IowaScaledEngineering/mss-cascade/doc/cascade-bag-top-landscape.odt

Iowa Scaled Engineering, LLC

http://iascaled.com/

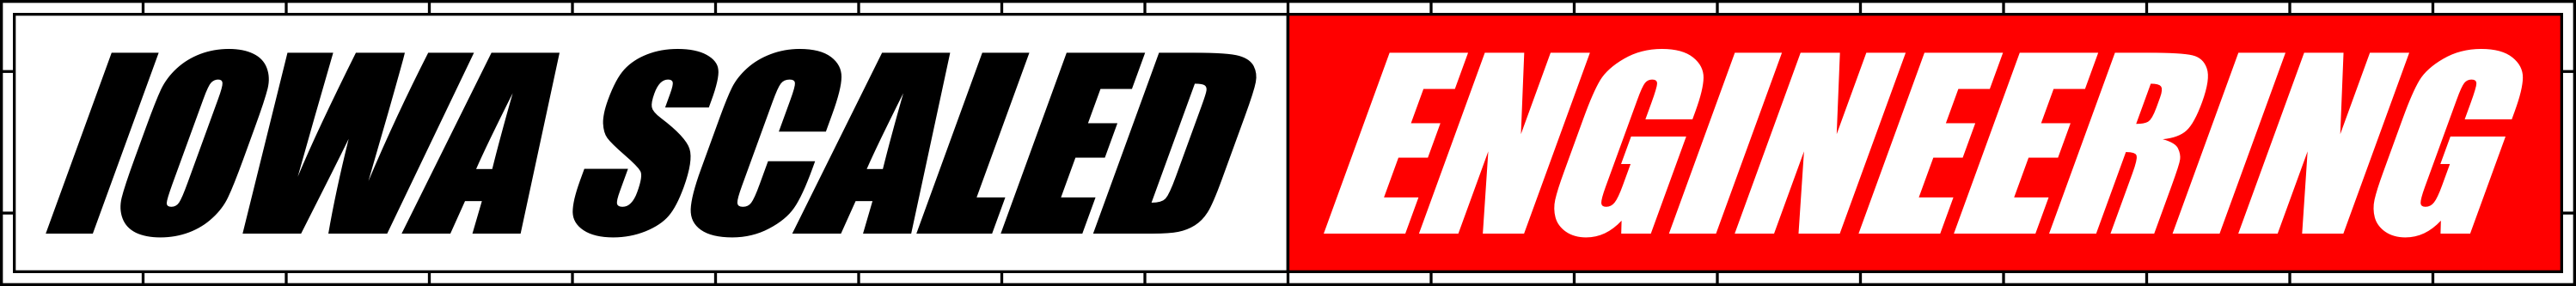
[picture p1: figure]

Modular Signaling System
Cascade Module

The MSS-CASCADE is a fully integrated module implementing the Module Signaling System (MSS) cascade function, providing simple ABS signal functionality at a block boundary. It contains the block detection circuitry, optical detector, MSS bus logic, and LED signal drivers.

MSS-CASCADE
