IowaScaledEngineering/mss-cascade/pg/mss-cascade-adv-v1.0-99f0320/mss-cascade-adv.pdf

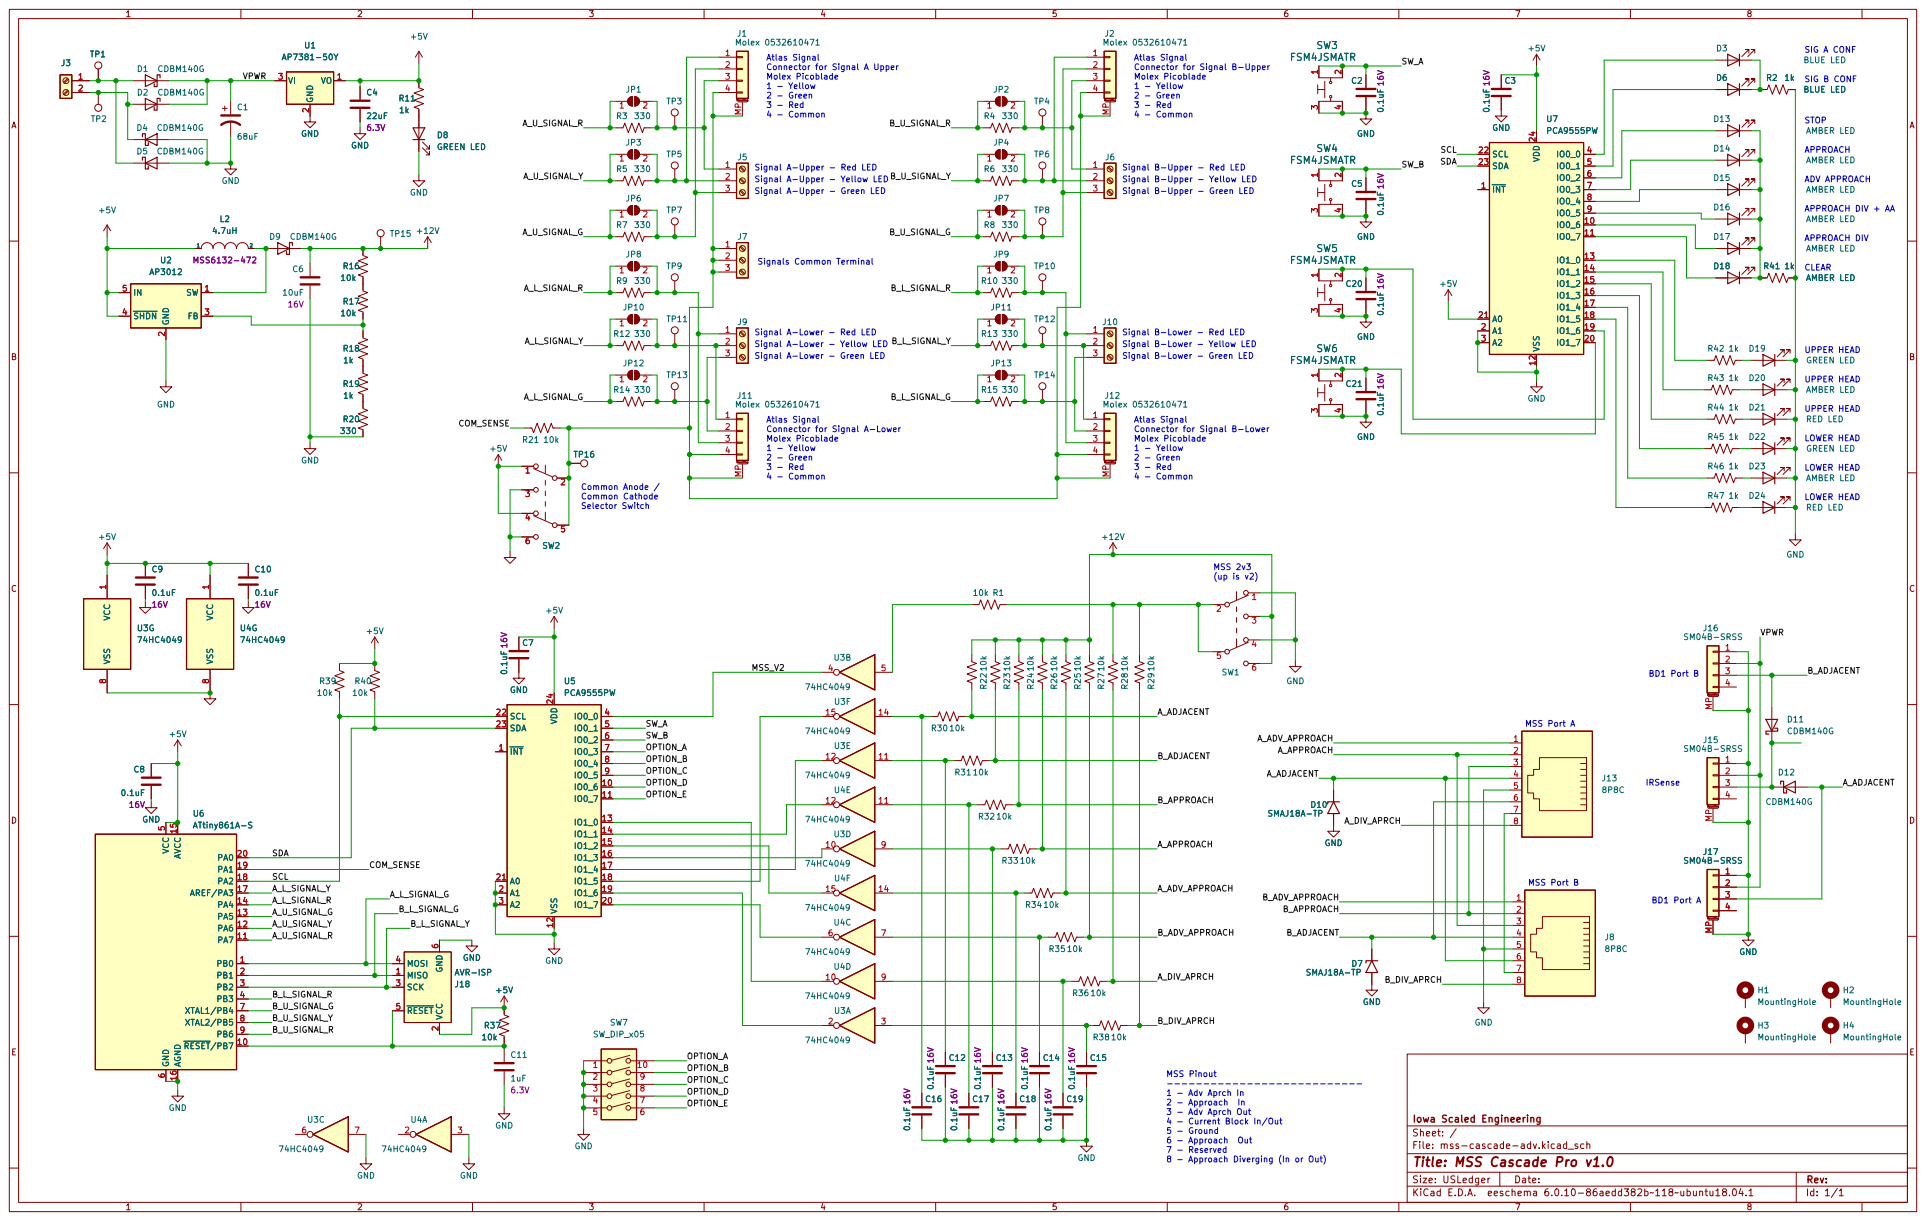
[picture p8: page 1]

Atlas Signal
Connector for Signal A Upper Molex Picoblade

Connector for Signal B-Upper Molex Picoblade

Signal B-Lower - Red LED
Signal B-Lower - Yellow LED
4 - Common Signal B-Lower - Green LED

Connector for Signal A-Lower Molex Picoblade

Connector for Signal B-Lower Molex Picoblade

2 SCK 3 MOSI 4 ~{RESET} 5 GND

MSS Pinout --------------------------- 1 - Adv Aprch In

2 - Approach In
3 - Adv Aprch Out 4 - Current Block In/Out 5 - Ground

Iowa Scaled Engineering
File: mss-cascade-adv.kicad_sch Sheet: /
Id: 1/1 Title: MSS Cascade Pro v1.0

8 - Approach Diverging (In or Out)
