IowaScaledEngineering/mss-cascade/pg/mss-cascade-basic-v1.1-02db50d/mss-cascade-basic.pdf

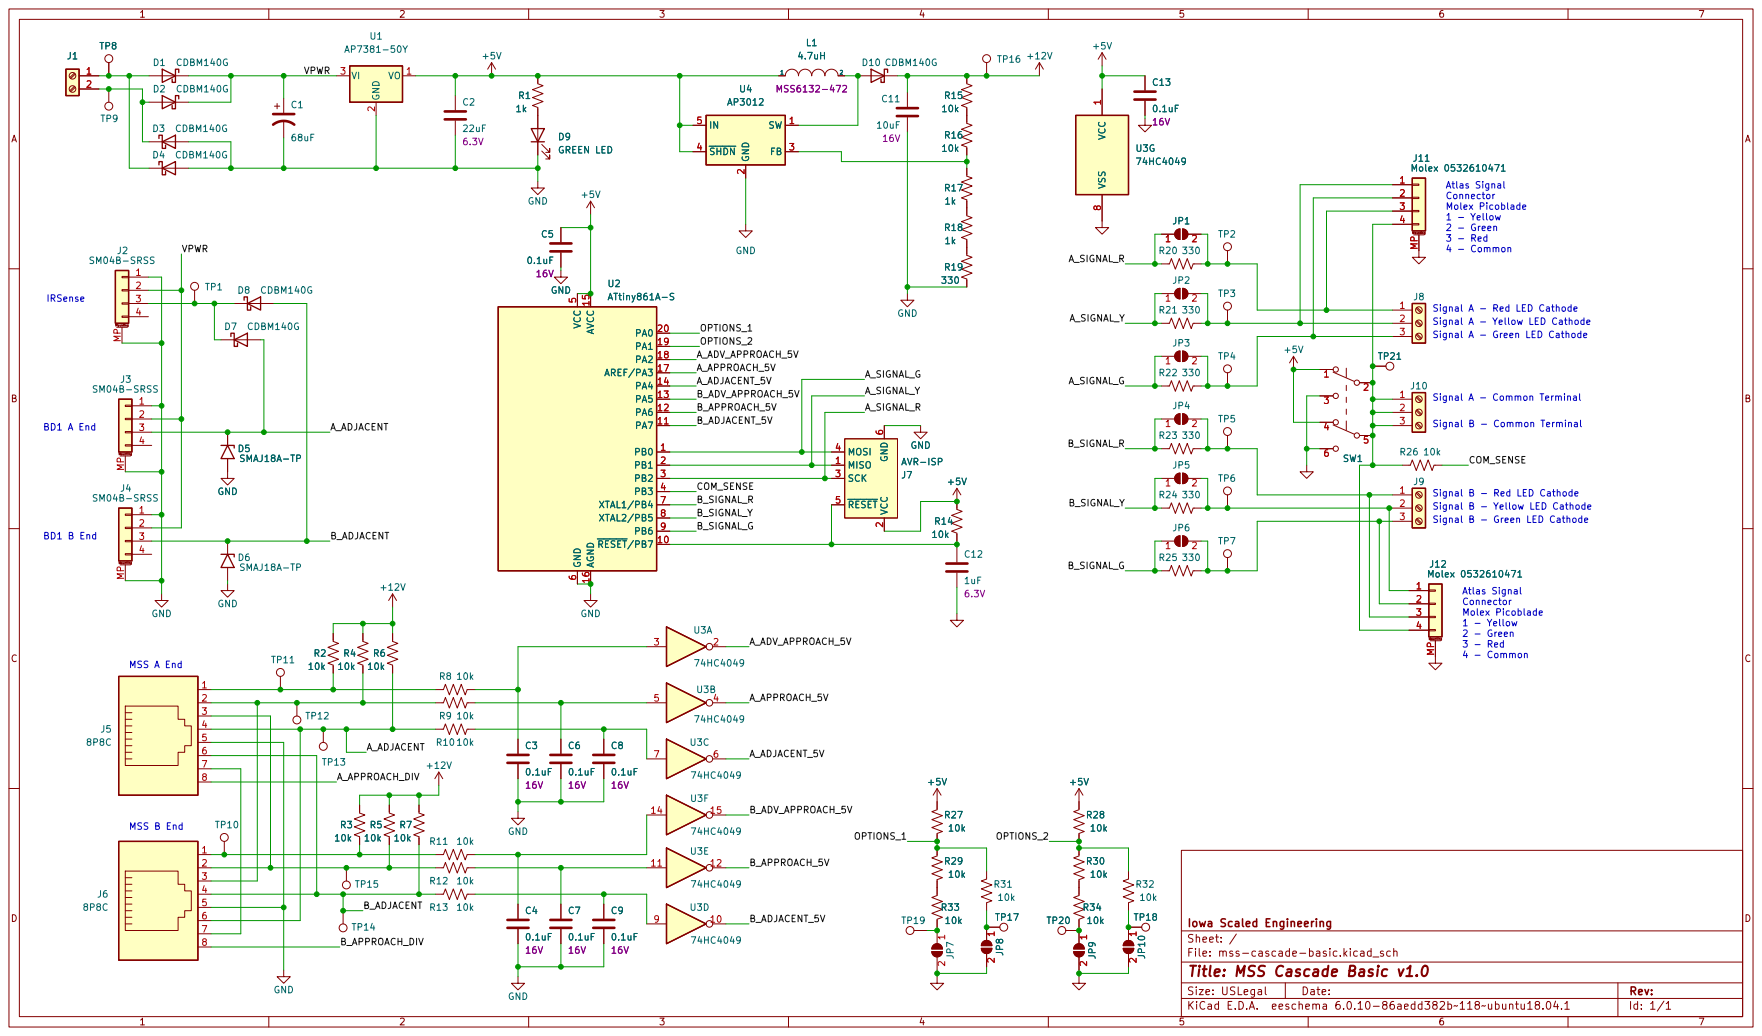
[picture p9: page 1]

Atlas Signal Connector Molex Picoblade

2 SCK 3 MOSI 4 ~{RESET} 5 GND

Signal B - Red LED Cathode

Signal B - Green LED Cathode

Iowa Scaled Engineering
File: mss-cascade-basic.kicad_sch Sheet: /
Id: 1/1 Title: MSS Cascade Basic v1.0
