IowaScaledEngineering/mss-cascade/pg/mss-cascade-v1.1-7f48456/mss-cascade.pdf

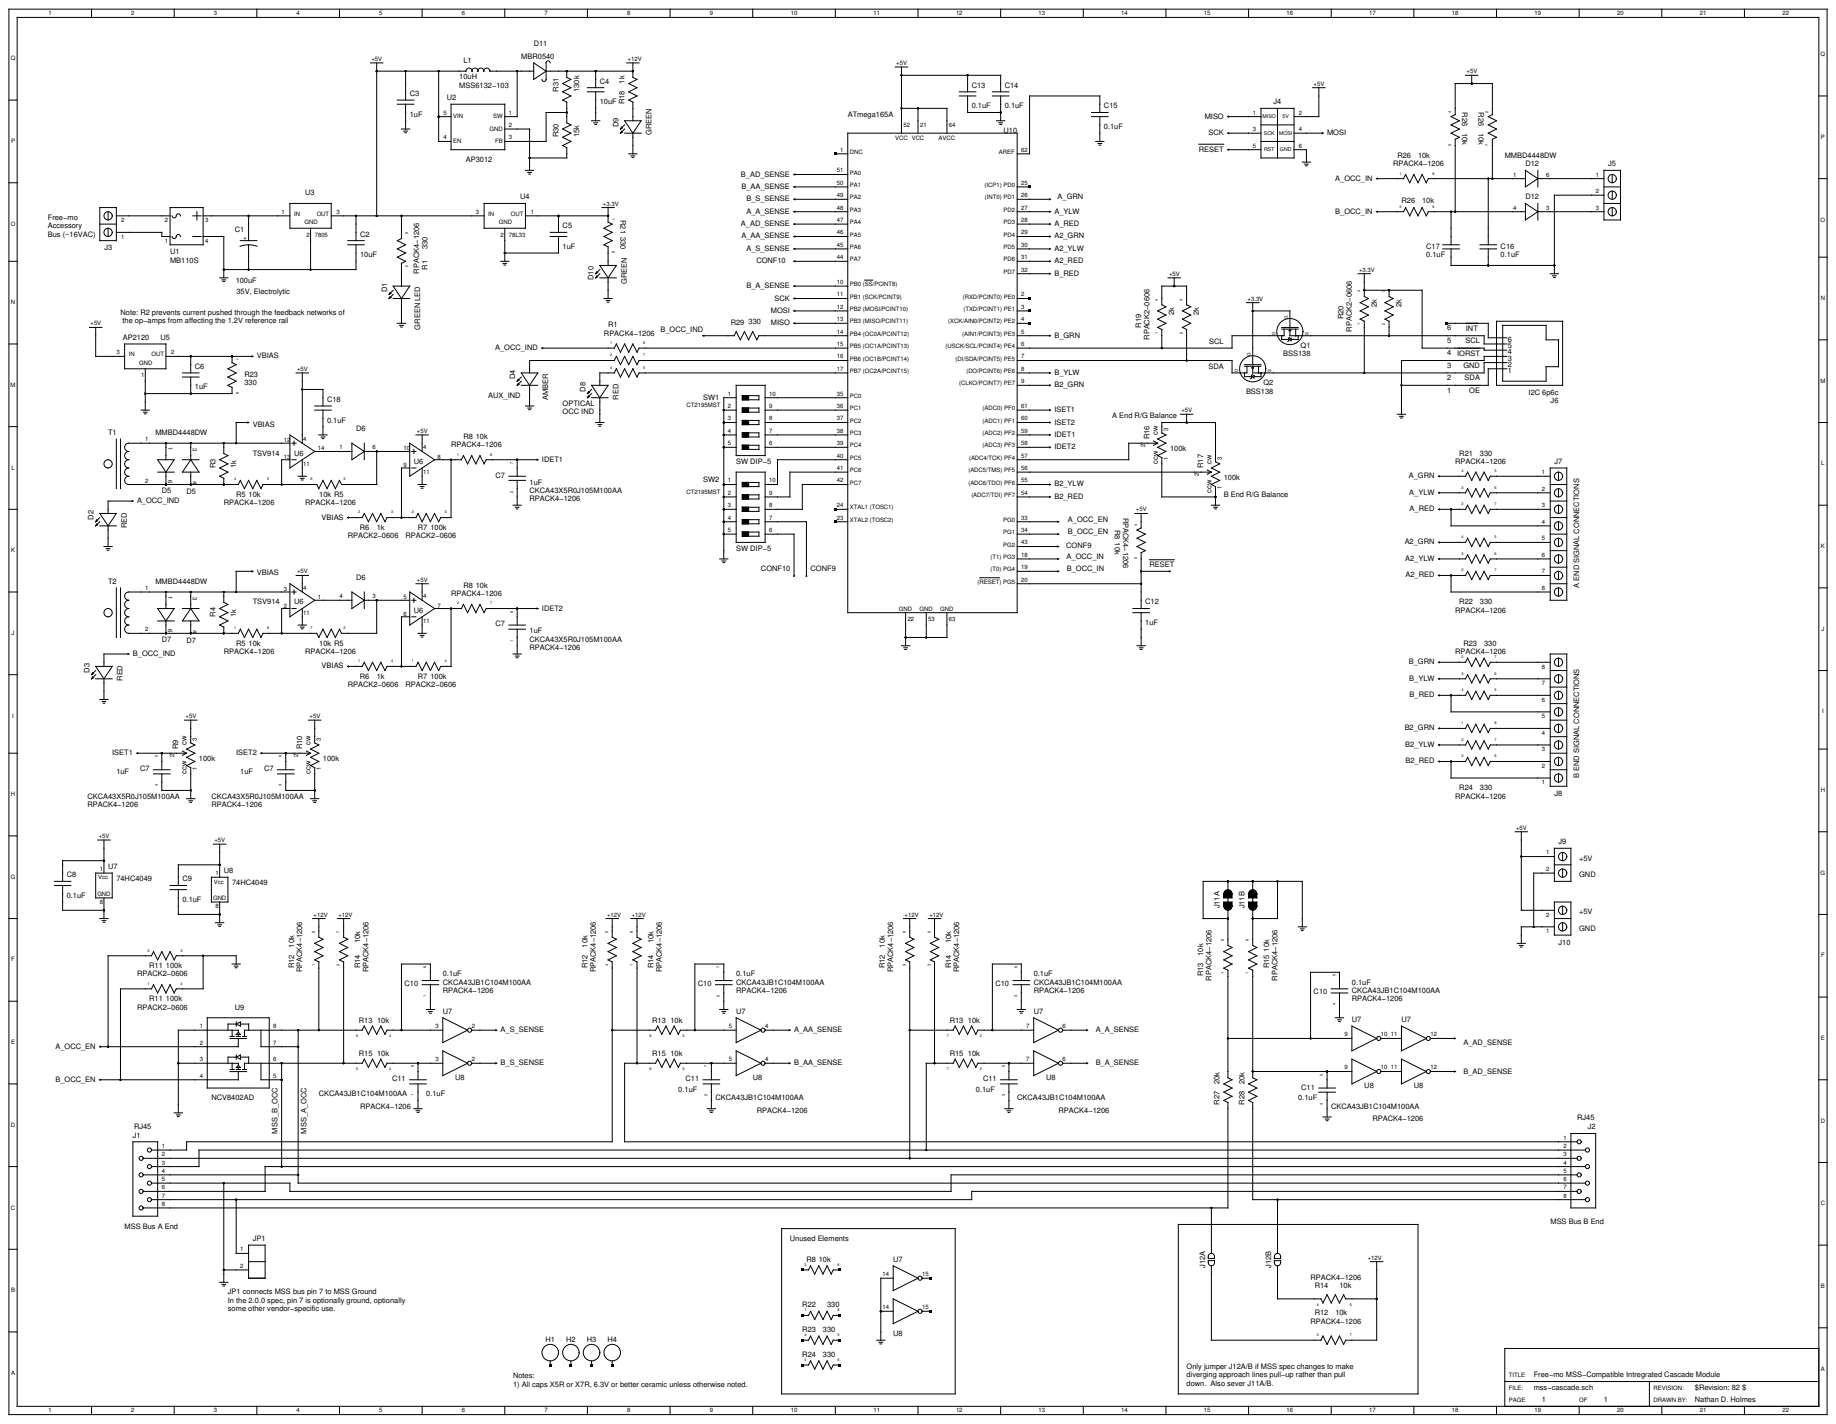
[picture p19: page 1]

Note: R2 prevents current pushed through the feedback networks of

the op−amps from affecting the 1.2V reference rail +5V

A END SIGNAL CONNECTIONS B END SIGNAL CONNECTIONS

JP1 connects MSS bus pin 7 to MSS Ground
In the 2.0.0 spec, pin 7 is optionally ground, optionally
some other vendor−specific use.

Only jumper J12A/B if MSS spec changes to make
diverging approach lines pull−up rather than pull
down. Also sever J11A/B.

Notes:
1) All caps X5R or X7R, 6.3V or better ceramic unless otherwise noted.

Free−mo MSS−Compatible Intregrated Cascade Module
mss−cascade.sch
