IowaScaledEngineering/mss-cascade/pg/mss-cascade-v1.0-fcae942/mss-cascade-pcb.pdf

# mss-cascade.pcb

# 1. Table of Contents (This Page) Created on Thu Dec 3 10:56:44 2015

# 2. component 3. solder 4. outline 5. plated-drill 6. componentmask 7. soldermask 8. topsilk 9. bottomsilk 10. toppaste 11. topassembly 12. bottomassembly 13. fab

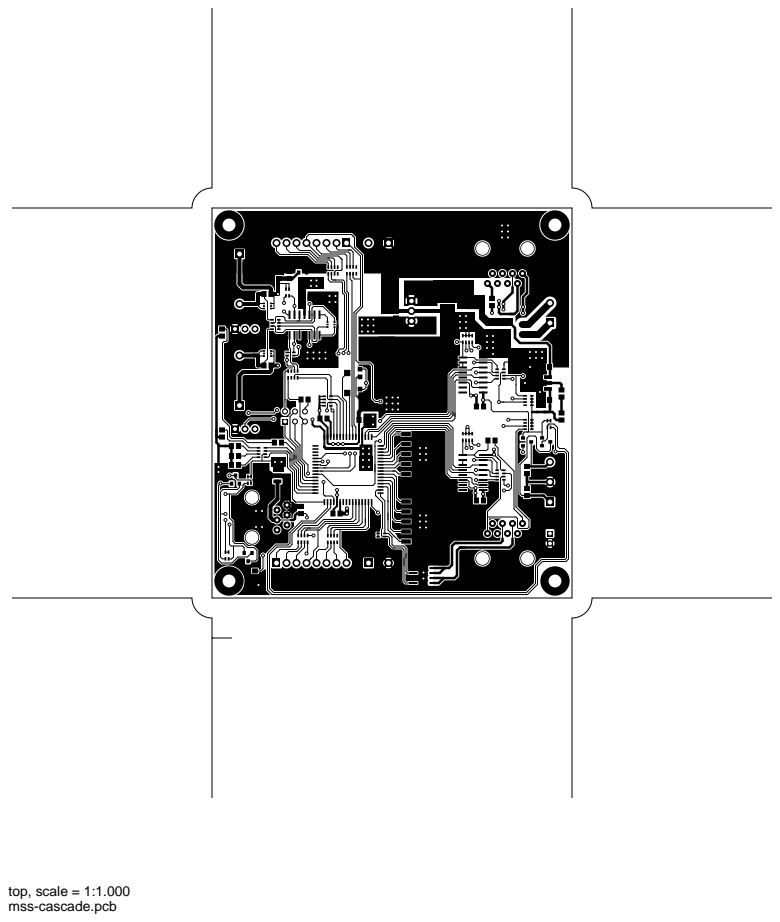
[picture p20: page 2]
top, scale = 1:1.000

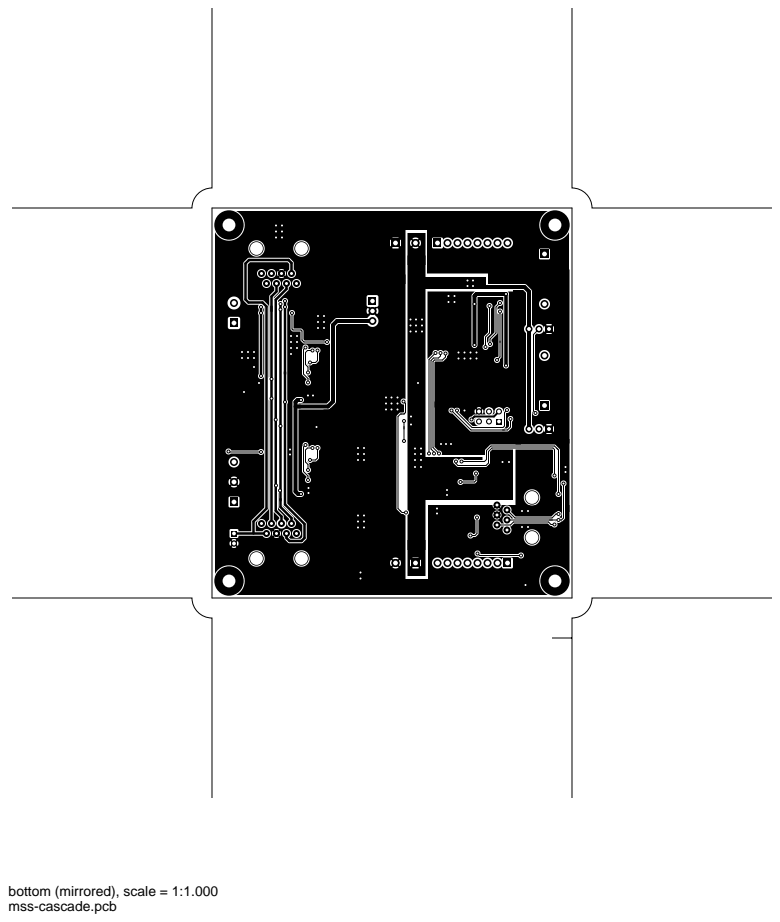
[picture p21: page 3]

bottom (mirrored), scale = 1:1.000

outline, scale = 1:1.000

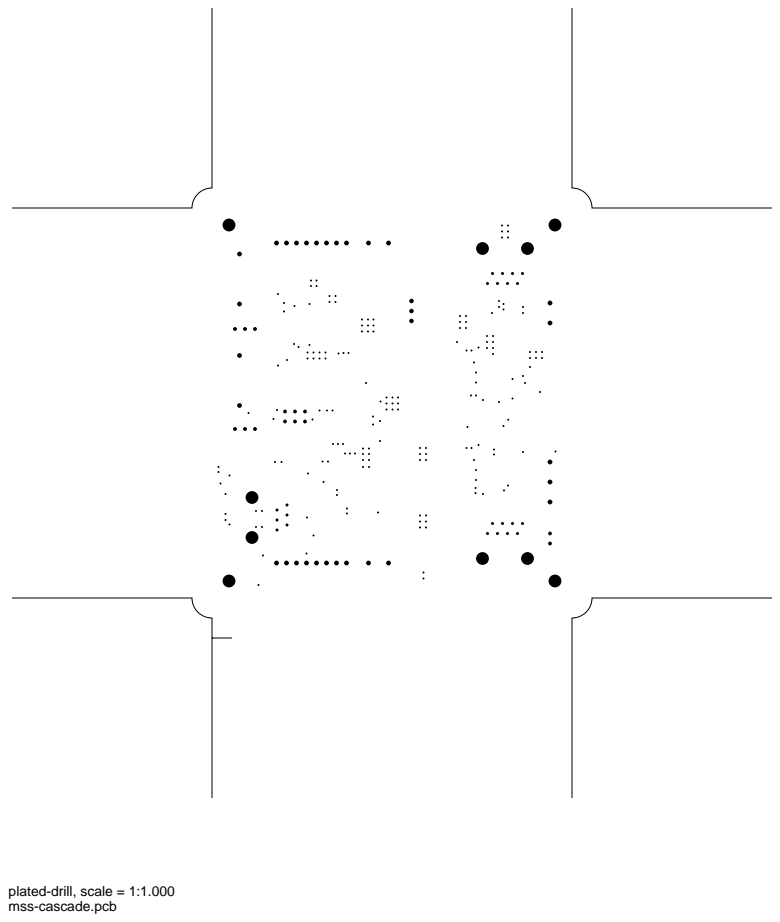
[picture p22: page 5]

plated-drill, scale = 1:1.000

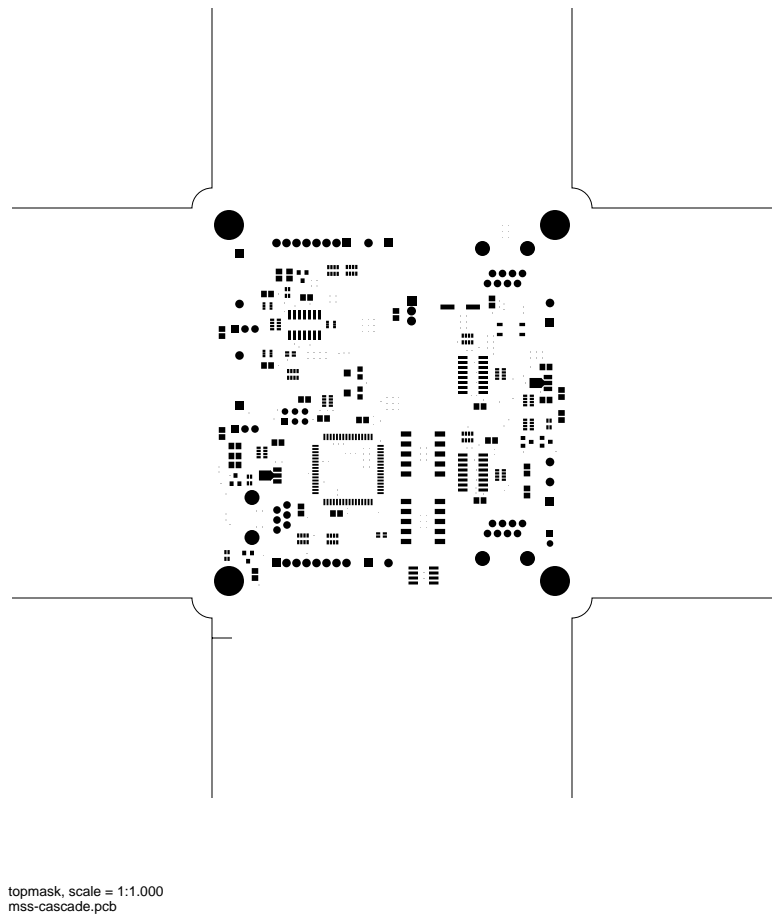
[picture p23: page 6]
topmask, scale = 1:1.000

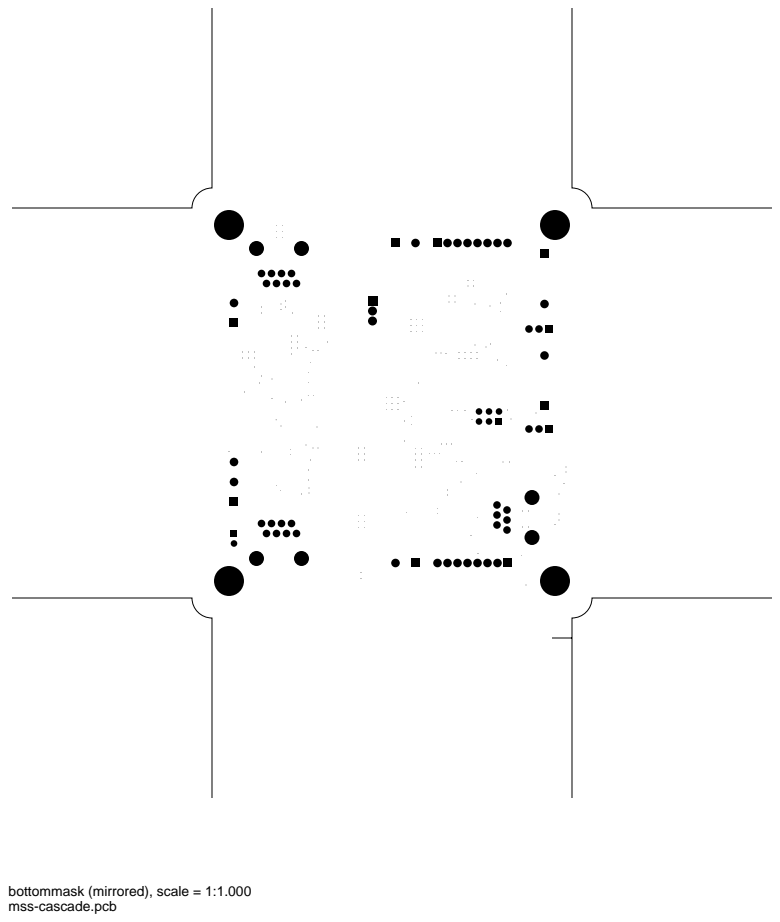
[picture p24: page 7]

bottommask (mirrored), scale = 1:1.000

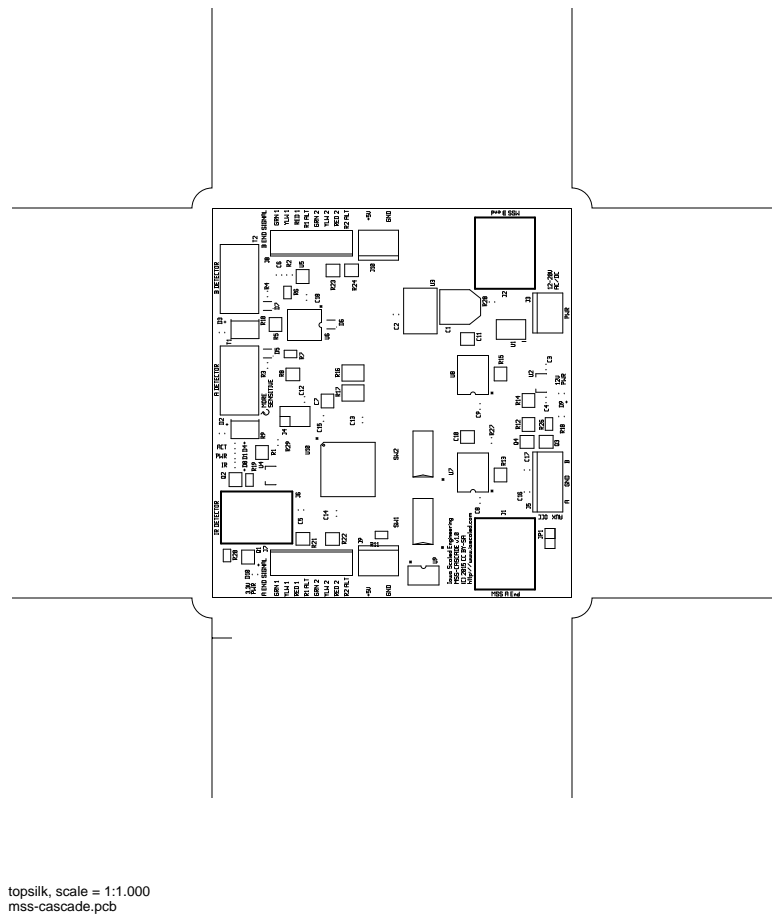
[picture p25: page 8]
topsilk, scale = 1:1.000

bottomsilk (mirrored), scale = 1:1.000

toppaste, scale = 1:1.000

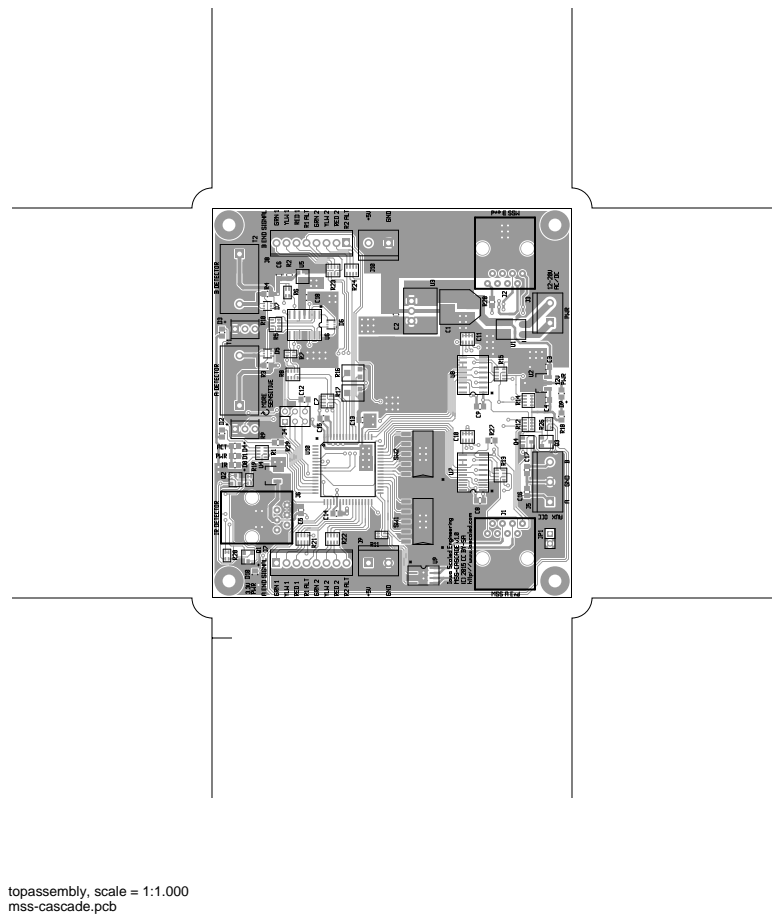
[picture p26: page 11]
topassembly, scale = 1:1.000

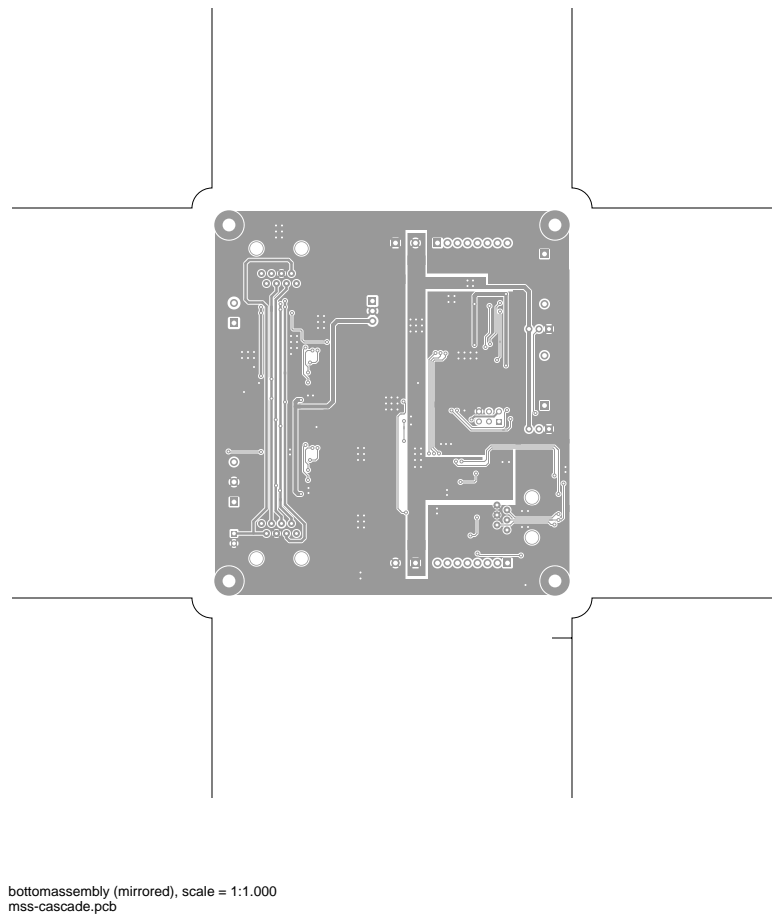
[picture p27: page 12]

bottomassembly (mirrored), scale = 1:1.000

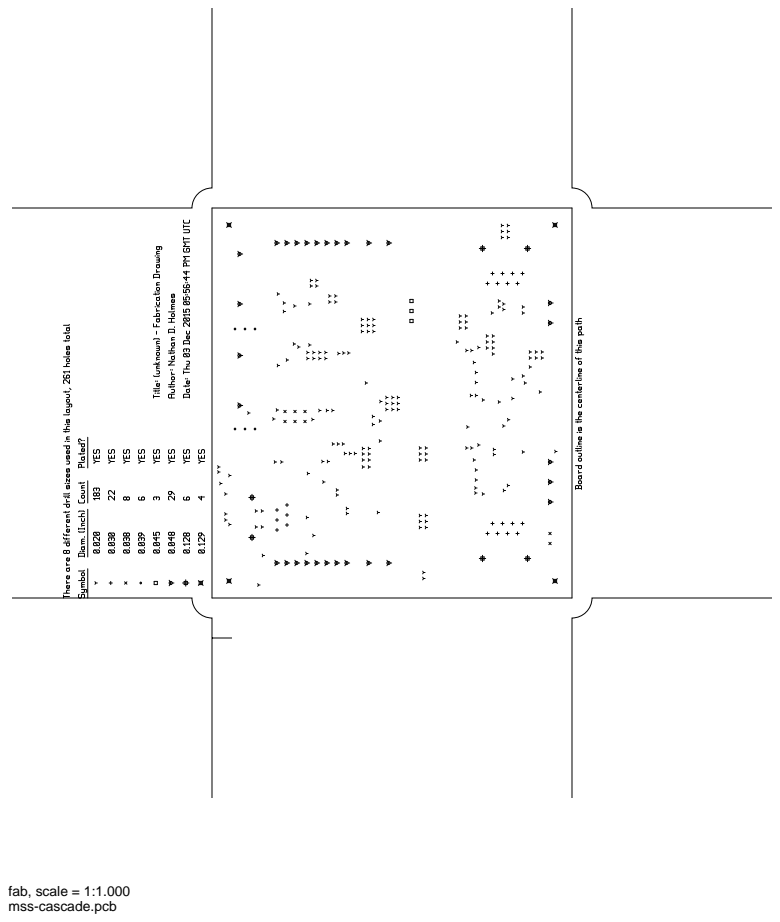
[picture p28: page 13]
fab, scale = 1:1.000
