IowaScaledEngineering/mss-cascade/(list of files, drawings)

Other design files:
pcb/mss-cascade.pcb
