IowaScaledEngineering/mss-cascade/kicad/mss-cascade-basic-testjig/mss-cascade-basic-testjig.kicad_pcb

## KiCad design kicad/mss-cascade-basic-testjig/mss-cascade-basic-testjig.kicad_pcb (2025-02-23)

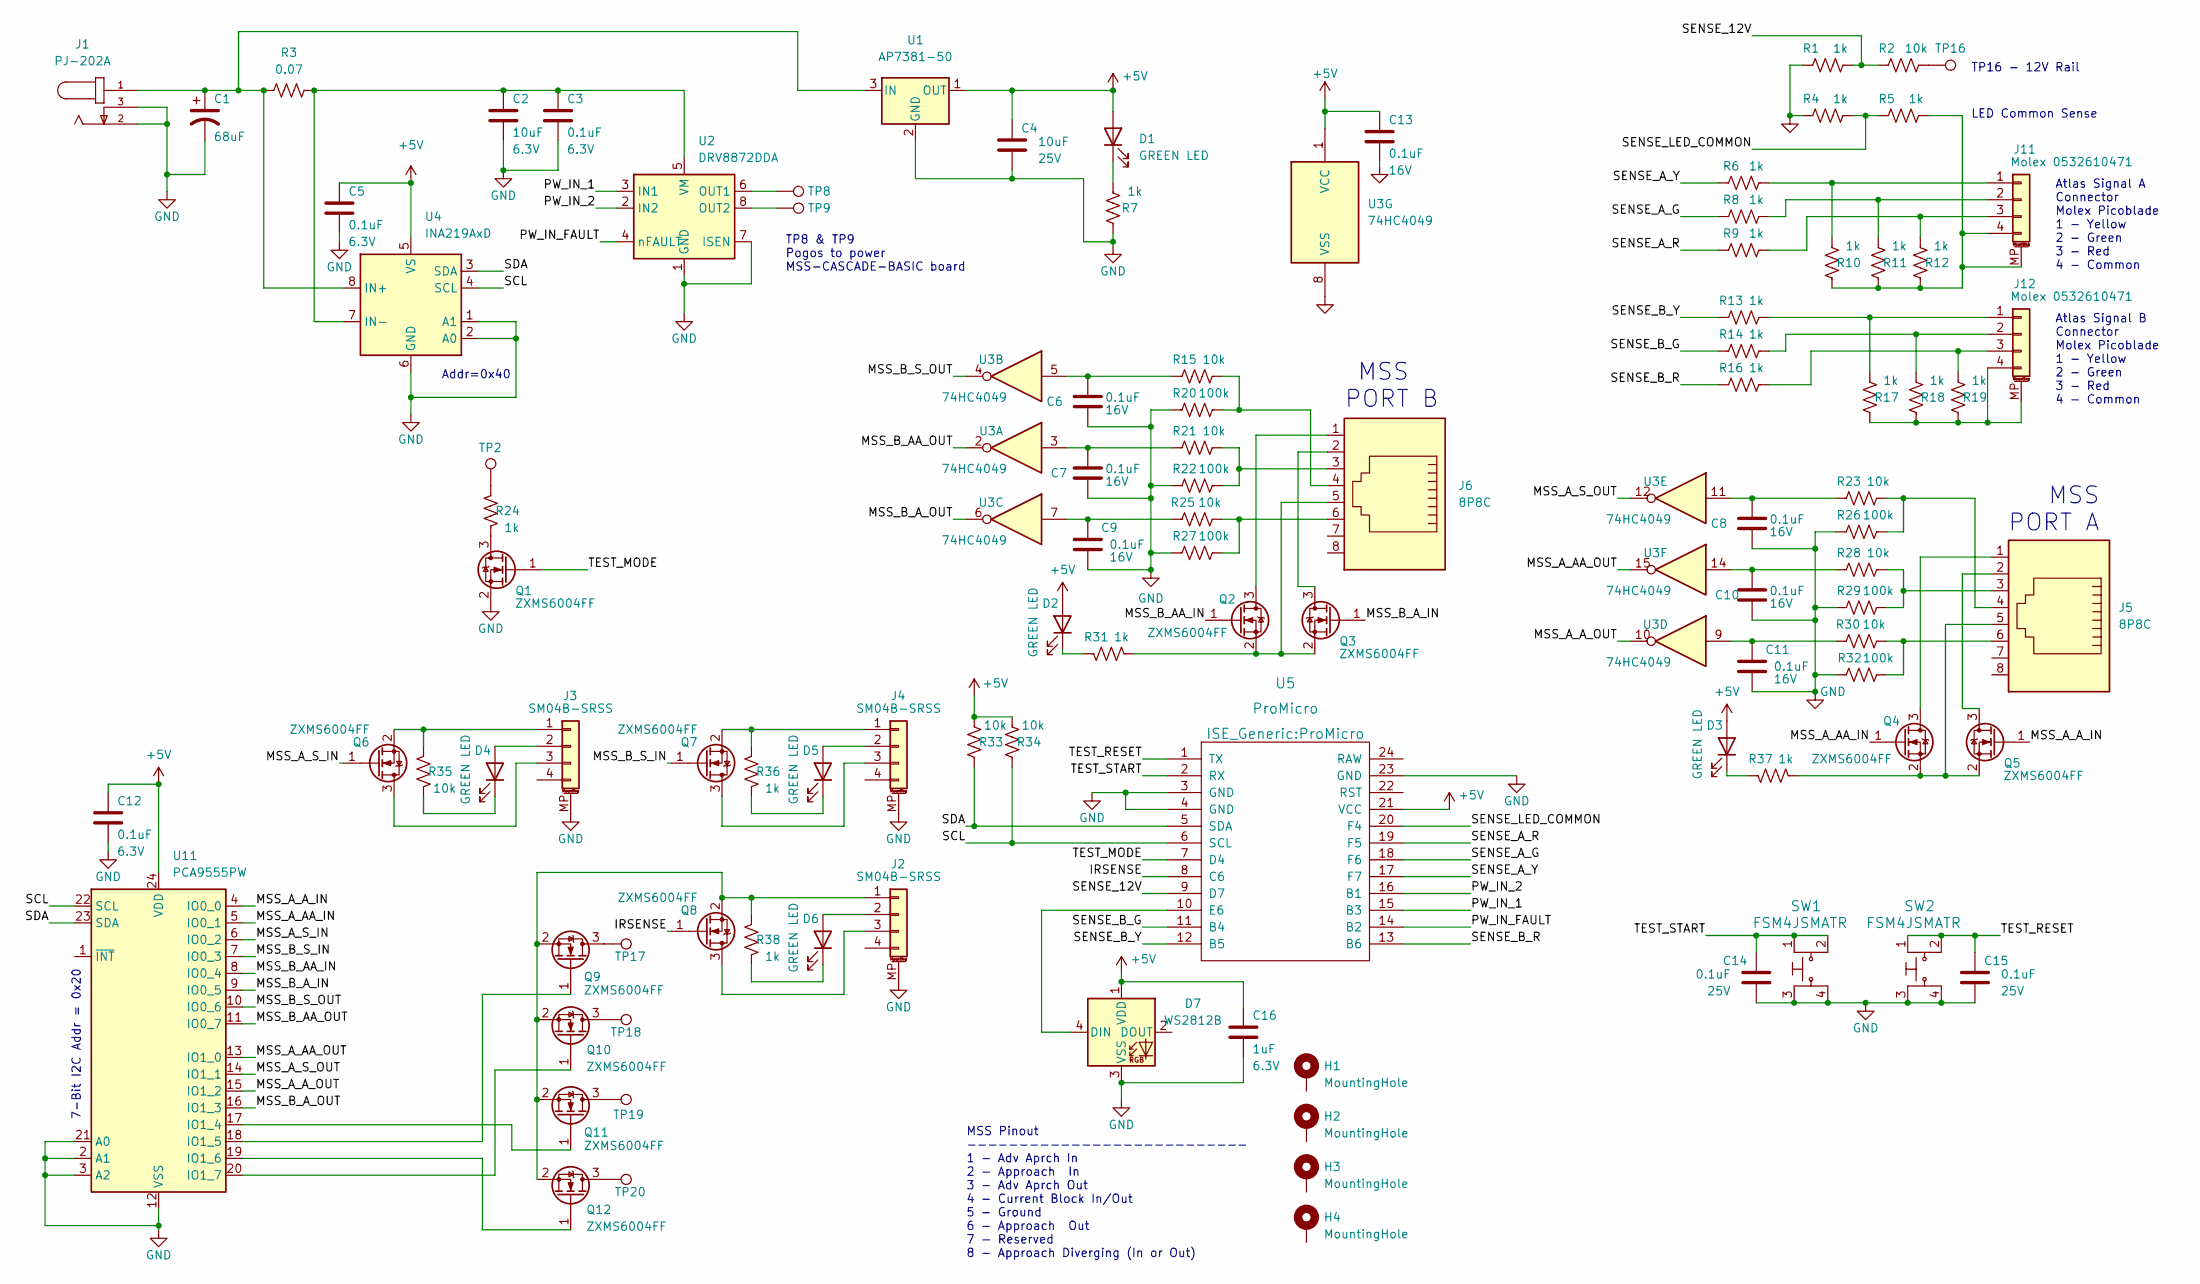
[picture p29: schematic mss-cascade-basic-testjig.kicad_sch, MSS Cascade Basic Test Jig]

Parts:
C1: 68uF; CP_Elec_6.3x5.8
C2: 10uF; C_0805_2012Metric; Voltage 6.3V
C3, C5, C12: 0.1uF; C_0805_2012Metric; Voltage 6.3V
C4: 10uF; C_0805_2012Metric; Voltage 25V
C6, C7, C8, C9, C10, C11, C13: 0.1uF; C_0805_2012Metric; Voltage 16V
C14, C15: 0.1uF; C_0805_2012Metric; Voltage 25V
C16: 1uF; C_0805_2012Metric; Voltage 6.3V
D1, D2, D3, D4, D5, D6: GREEN LED; LED_0805_2012Metric
D7: WS2812B; LED_WS2812B_PLCC4_5.0x5.0mm_P3.2mm
H1, H2, H3, H4: MountingHole; MountingHole_3.2mm_M3_Pad
J1: PJ-202A; CUI_PJ-202A
J2, J3, J4: SM04B-SRSS; JST_SH_SM04B-SRSS-TB_1x04-1MP_P1.00mm_Horizontal
J5, J6: 8P8C; RJ45_Amphenol_54602-x08_Horizontal
J11, J12: Molex 0532610471; Molex_PicoBlade_53261-0471_1x04-1MP_P1.25mm_Horizontal
Q1, Q2, Q3, Q4, Q5, Q6, Q7, Q8, Q9, Q10, Q11, Q12: ZXMS6004FF; SOT-23
R1, R4, R5, R6, R7, R8, R9, R10, R11, R12, R13, R14, R16, R17, R18, R19, R24, R31, R36, R37, R38: 1k; R_0805_2012Metric
R2, R15, R21, R23, R25, R28, R30, R33, R34, R35: 10k; R_0805_2012Metric
R3: 0.07; R_2512_6332Metric
R20, R22, R26, R27, R29, R32: 100k; R_0805_2012Metric
SW1, SW2: FSM4JSMATR; TE_FSM4JSMA; MPN FSM4JSMATR; Digi-Key_PN 450-1759-1-ND
TP2, TP8, TP9, TP16, TP17, TP18, TP19, TP20: TestPoint; PinHeader_1x01_P2.54mm_Vertical
U1: AP7381-50; SOT-89-3
U2: DRV8872DDA; Texas_HSOP-8-1EP_3.9x4.9mm_P1.27mm
U3: 74HC4049; SO-16_3.9x9.9mm_P1.27mm
U4: INA219AxD; SOIC-8_3.9x4.9mm_P1.27mm
U5: ProMicro
U11: PCA9555PW; TSSOP-24_4.4x7.8mm_P0.65mm

Connections:
+5V: C4.1, C5.1, C12.1, C13.1, C16.1, D1.2 (A), D2.2 (A), D3.2 (A), D7.1 (VDD), R33.1, R34.1, U1.1 (OUT), U3.1 (VCC), U4.5 (VS), U5.21 (VCC), U11.24 (VDD)
/IRSENSE: Q8.1 (G), U5.8 (C6)
/MSS_A_AA_IN: Q4.1 (G), U11.5 (IO0_1)
/MSS_A_AA_OUT: U3.15, U11.13 (IO1_0)
/MSS_A_A_IN: Q5.1 (G), U11.4 (IO0_0)
/MSS_A_A_OUT: U3.10, U11.15 (IO1_2)
/MSS_A_S_IN: Q6.1 (G), U11.6 (IO0_2)
/MSS_A_S_OUT: U3.12, U11.14 (IO1_1)
/MSS_B_AA_IN: Q2.1 (G), U11.8 (IO0_4)
/MSS_B_AA_OUT: U3.2, U11.11 (IO0_7)
/MSS_B_A_IN: Q3.1 (G), U11.9 (IO0_5)
/MSS_B_A_OUT: U3.6, U11.16 (IO1_3)
/MSS_B_S_IN: Q7.1 (G), U11.7 (IO0_3)
/MSS_B_S_OUT: U3.4, U11.10 (IO0_6)
/PW_IN_1: U2.3 (IN1), U5.15 (B3)
/PW_IN_2: U2.2 (IN2), U5.16 (B1)
/PW_IN_FAULT: U2.4 (nFAULT), U5.14 (B2)
/SCL: R34.2, U4.4 (SCL), U5.6 (SCL), U11.22 (SCL)
/SDA: R33.2, U4.3 (SDA), U5.5 (SDA), U11.23 (SDA)
/SENSE_12V: R1.2, R2.1, U5.9 (D7)
/SENSE_A_G: R8.1, U5.18 (F6)
/SENSE_A_R: R9.1, U5.19 (F5)
/SENSE_A_Y: R6.1, U5.17 (F7)
/SENSE_B_G: R14.1, U5.11 (B4)
/SENSE_B_R: R16.1, U5.13 (B6)
/SENSE_B_Y: R13.1, U5.12 (B5)
/SENSE_LED_COMMON: R4.2, R5.1, U5.20 (F4)
/TEST_MODE: Q1.1 (G), U5.7 (D4)
/TEST_RESET: C15.1, SW2.1, SW2.2, U5.1 (TX)
/TEST_START: C14.1, SW1.1, SW1.2, U5.2 (RX)
GND: C1.2, C2.2, C3.2, C4.2, C5.2, C6.2, C7.2, C8.2, C9.2, C10.2, C11.2, C12.2, C13.2, C14.2, C15.2, C16.2, D7.3 (VSS), J1.2, J1.3, J2.MP (MountPin), J3.MP (MountPin), J4.MP (MountPin), Q1.2 (S), R1.1, R4.1, R7.2, R20.2, R22.2, R26.2, R27.2, R29.2, R32.2, SW1.3, SW1.4, SW2.3, SW2.4, U1.2 (GND), U2.1 (GND), U2.7 (ISEN), U2.9 (GND), U3.8 (VSS), U4.1 (A1), U4.2 (A0), U4.6 (GND), U5.3 (GND), U5.4 (GND), U5.23 (GND), U11.2 (A1), U11.3 (A2), U11.12 (VSS), U11.21 (A0)
unnamed: C1.1, J1.1, R3.2, U1.3 (IN), U4.8 (IN+)
unnamed: C2.1, C3.1, R3.1, U2.5 (VM), U4.7 (IN-)
unnamed: C6.1, R15.2, U3.5
unnamed: C7.1, R21.2, U3.3
unnamed: C8.1, R23.2, U3.11
unnamed: C9.1, R25.2, U3.7
unnamed: C10.1, R28.2, U3.14
unnamed: C11.1, R30.2, U3.9
unnamed: D1.1 (K), R7.1
unnamed: D2.1 (K), R31.2
unnamed: D3.1 (K), R37.2
unnamed: D4.1 (K), R35.1
unnamed: D4.2 (A), J3.2
unnamed: D5.1 (K), R36.1
unnamed: D5.2 (A), J4.2
unnamed: D6.1 (K), R38.1
unnamed: D6.2 (A), J2.2
unnamed: D7.4 (DIN), U5.10 (E6)
unnamed: J2.1, Q8.2 (S), Q9.2 (S), Q10.2 (S), Q11.2 (S), Q12.2 (S), R38.2
unnamed: J2.3, Q8.3 (D)
unnamed: J3.1, Q6.2 (S), R35.2
unnamed: J3.3, Q6.3 (D)
unnamed: J4.1, Q7.2 (S), R36.2
unnamed: J4.3, Q7.3 (D)
unnamed: J5.1, Q4.3 (D)
unnamed: J5.2, Q5.3 (D)
unnamed: J5.3, R28.1, R29.1
unnamed: J5.4, R23.1, R26.1
unnamed: J5.5, Q4.2 (S), Q5.2 (S), R37.1
unnamed: J5.6, R30.1, R32.1
unnamed: J6.1, Q2.3 (D)
unnamed: J6.2, Q3.3 (D)
unnamed: J6.3, R21.1, R22.1
unnamed: J6.4, R15.1, R20.1
unnamed: J6.5, Q2.2 (S), Q3.2 (S), R31.1
unnamed: J6.6, R25.1, R27.1
unnamed: J11.1, R6.2, R10.1
unnamed: J11.2, R8.2, R11.1
unnamed: J11.3, R9.2, R12.1
unnamed: J11.4, J11.MP (MountPin), R5.2, R10.2, R11.2, R12.2
unnamed: J12.1, R13.2, R17.1
unnamed: J12.2, R14.2, R18.1
unnamed: J12.3, R16.2, R19.1
unnamed: J12.4, J12.MP (MountPin), R17.2, R18.2, R19.2
unnamed: Q1.3 (D), R24.1
unnamed: Q9.1 (G), U11.18 (IO1_5)
unnamed: Q9.3 (D), TP17.1
unnamed: Q10.1 (G), U11.20 (IO1_7)
unnamed: Q10.3 (D), TP18.1
unnamed: Q11.1 (G), U11.17 (IO1_4)
unnamed: Q11.3 (D), TP19.1
unnamed: Q12.1 (G), U11.19 (IO1_6)
unnamed: Q12.3 (D), TP20.1
unnamed: R2.2, TP16.1
unnamed: R24.2, TP2.1
unnamed: TP8.1, U2.6 (OUT1)
unnamed: TP9.1, U2.8 (OUT2)

Notes on the sheet:
MSS PORT A
Addr=0x40
Atlas Signal B Connector Molex Picoblade 1 - Yellow 2 - Green 3 - Red 4 - Common
MSS PORT B
MSS Pinout --------------------------- 1 - Adv Aprch In 2 - Approach In 3 - Adv Aprch Out 4 - Current Block In/Out 5 - Ground 6 - Approach Out 7 - Reserved 8 - Approach Diverging (In or Out)
TP8 & TP9 Pogos to power MSS-CASCADE-BASIC board
Atlas Signal A Connector Molex Picoblade 1 - Yellow 2 - Green 3 - Red 4 - Common
TP16 - 12V Rail
LED Common Sense
7-Bit I2C Addr = 0x20

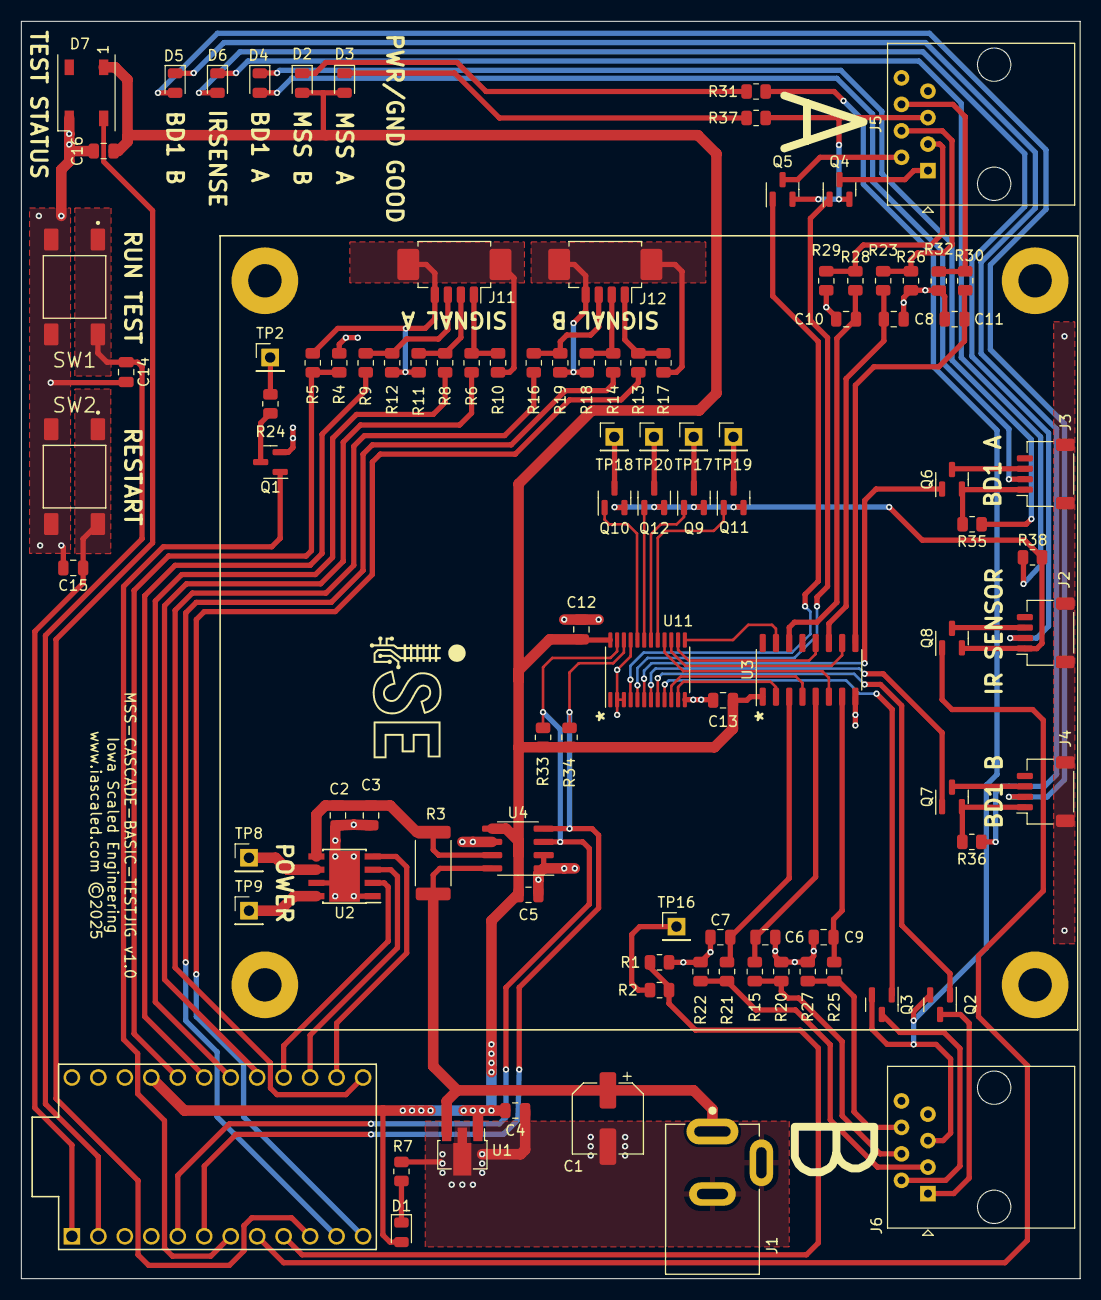
[picture p30: board mss-cascade-basic-testjig.kicad_pcb from above]

Board: 2 copper layers, 101.6 x 120.7 mm, 101 parts (0 on the bottom side), 88 nets.
