IowaScaledEngineering/mss-cascade/kicad/mss-cascade-adv/mss-cascade-adv.kicad_pcb

## KiCad design kicad/mss-cascade-adv/mss-cascade-adv.kicad_pcb (2025-01-05)

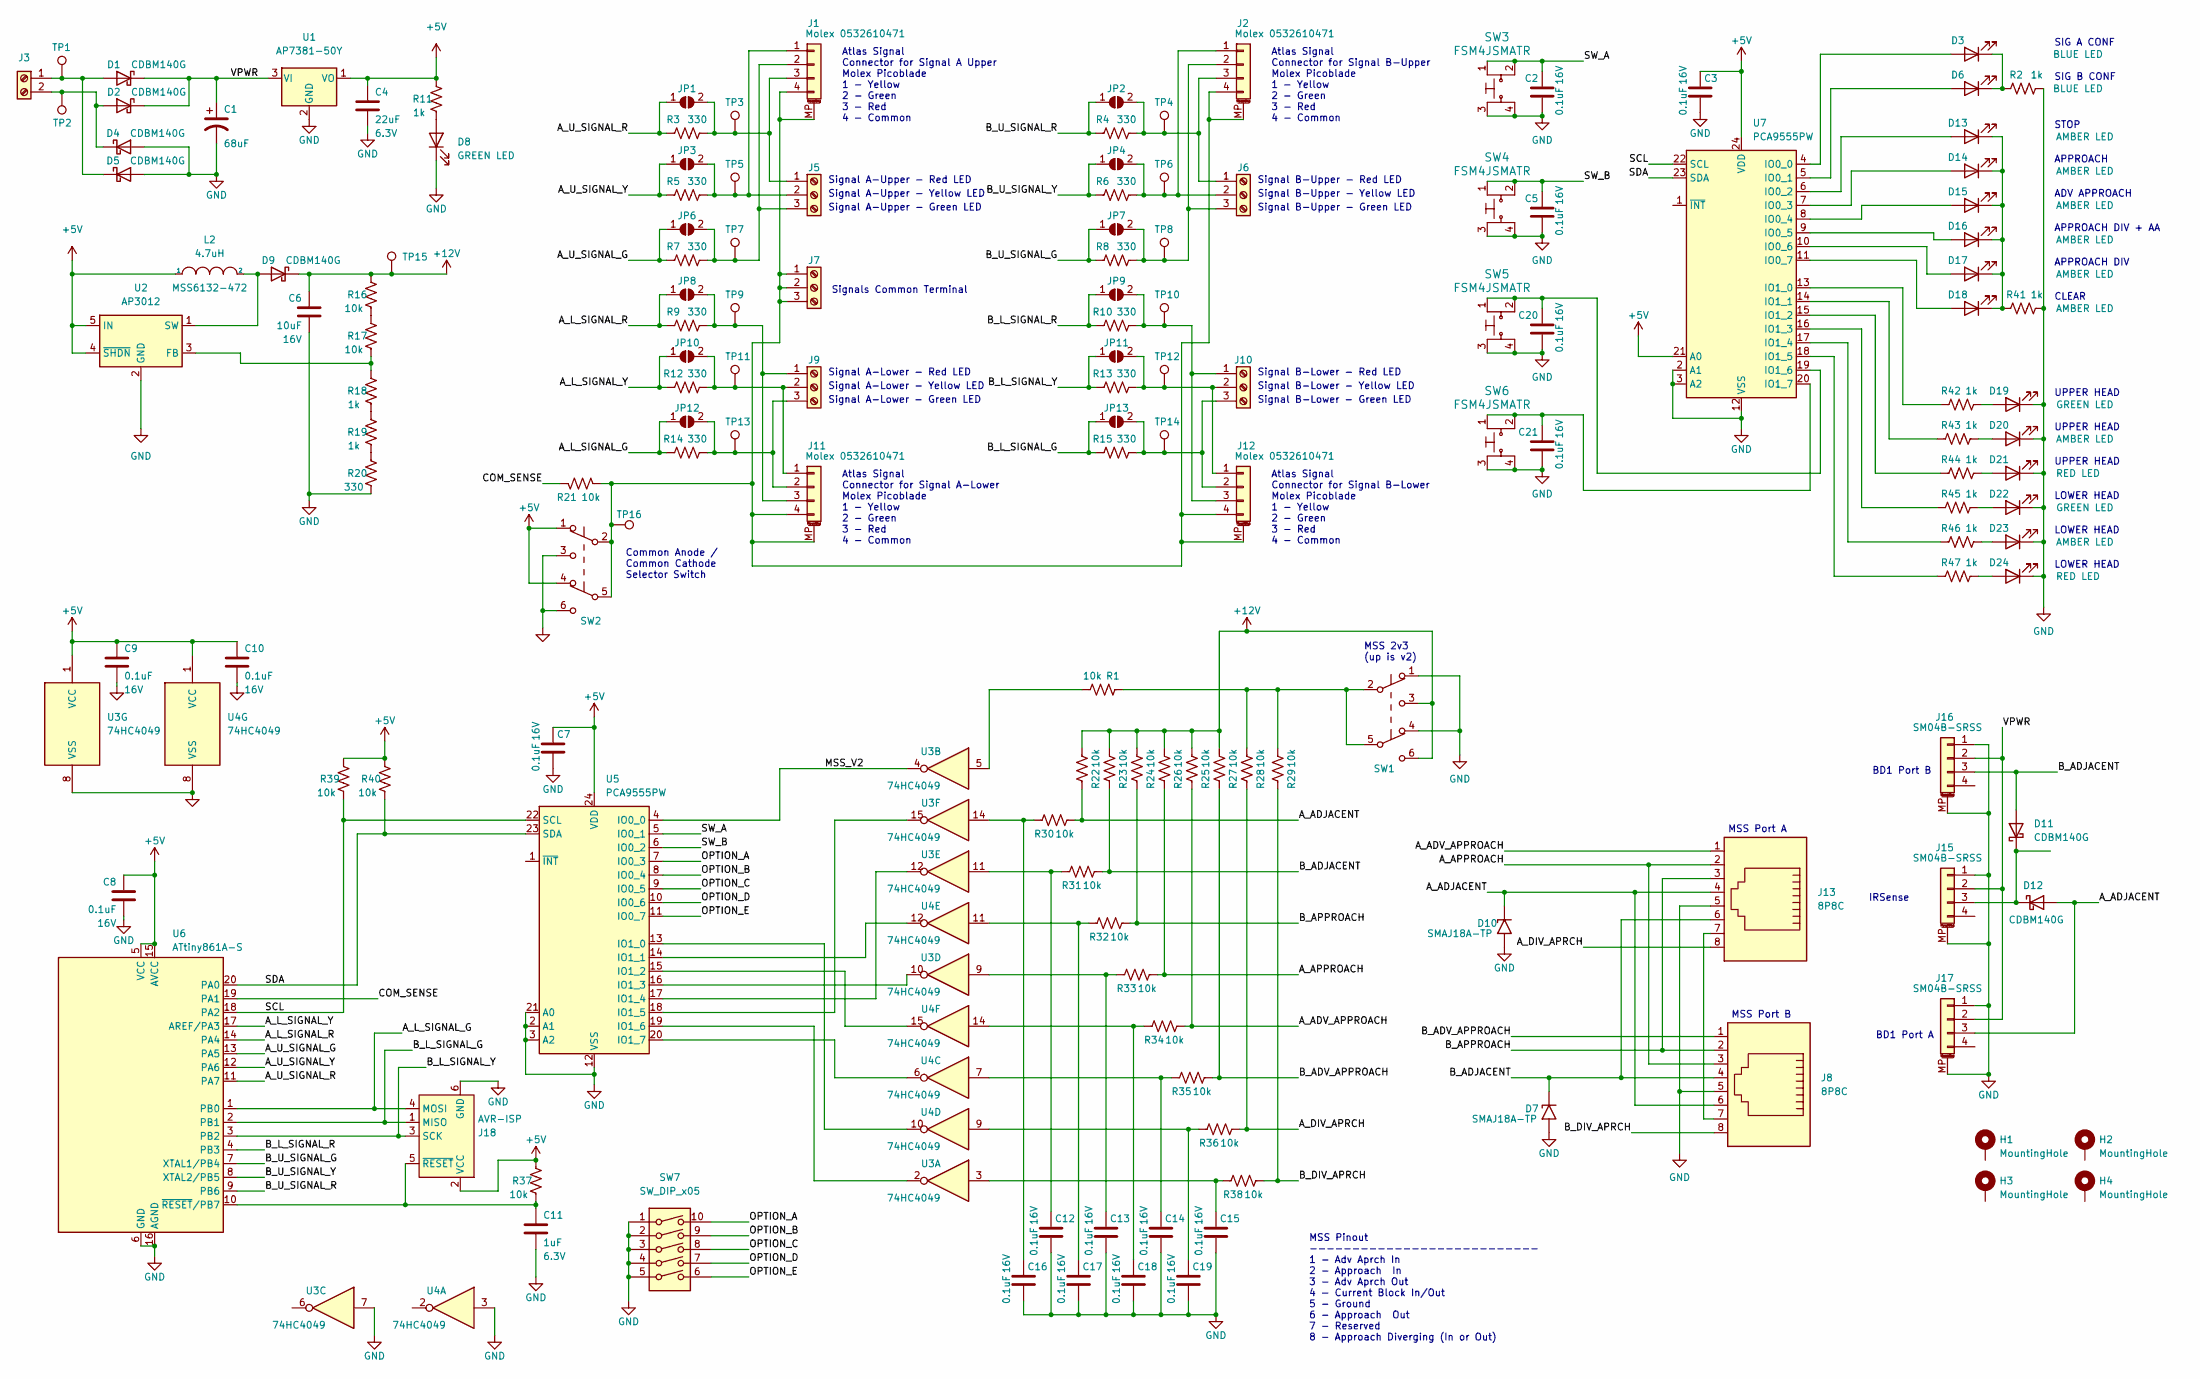
[picture p31: schematic mss-cascade-adv.kicad_sch, MSS Cascade Pro v1.0]

Parts:
C1: 68uF; CP_Elec_6.3x5.8
C2, C3, C5, C7, C8, C9, C10, C12, C13, C14, C15, C16, C17, C18, C19, C20, C21: 0.1uF; C_0805_2012Metric; Voltage 16V
C4: 22uF; C_0805_2012Metric; Voltage 6.3V
C6: 10uF; C_0805_2012Metric; Voltage 16V
C11: 1uF; C_0805_2012Metric; Voltage 6.3V
D1, D2, D4, D5, D9, D11, D12: CDBM140G; SOD-123T
D3, D6: BLUE LED; LED_0805_2012Metric
D7, D10: SMAJ18A-TP; D_SMA
D8, D19, D22: GREEN LED; LED_0805_2012Metric
D13, D14, D15, D16, D17, D18, D20, D23: AMBER LED; LED_0805_2012Metric
D21, D24: RED LED; LED_0805_2012Metric
H1, H2, H3, H4: MountingHole; MountingHole_3.2mm_M3_Pad
J1, J2, J11, J12: Molex 0532610471; Molex_PicoBlade_53261-0471_1x04-1MP_P1.25mm_Horizontal
J3: Screw_Terminal_01x02; TerminalBlock_RND_205-00012_1x02_P5.00mm_Horizontal
J5, J6, J7, J9, J10: Screw_Terminal_01x02; TerminalBlock_MetzConnect_Type059_RT06303HBWC_1x03_P3.50mm_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
J8, J13: 8P8C; RJ45_Amphenol_54602-x08_Horizontal
J15, J16, J17: SM04B-SRSS; JST_SH_SM04B-SRSS-TB_1x04-1MP_P1.00mm_Horizontal
J18: AVR-ISP; Tag-Connect_TC2030-IDC-NL_2x03_P1.27mm_Vertical
JP1, JP2, JP3, JP4, JP6, JP7, JP8, JP9, JP10, JP11, JP12, JP13: SolderJumper_2_Open; SolderJumper-2_P1.3mm_Open_RoundedPad1.0x1.5mm
L2: 4.7uH; MSS6132-xxxMLC
R1, R16, R17, R21, R22, R23, R24, R25, R26, R27, R28, R29, R30, R31, R32, R33, R34, R35, R36, R37, R38, R39, R40: 10k; R_0805_2012Metric
R2, R11, R18, R19, R41, R42, R43, R44, R45, R46, R47: 1k; R_0805_2012Metric
R3, R4, R5, R6, R7, R8, R9, R10, R12, R13, R14, R15, R20: 330; R_0805_2012Metric
SW1, SW2: JS202011SCQN; SW_JS202011SCQN
SW3, SW4, SW5, SW6: FSM4JSMATR; TE_FSM4JSMA; MPN FSM4JSMATR; Digi-Key_PN 450-1759-1-ND
SW7: SW_DIP_x05; SW_DIP_SPSTx05_Slide_6.7x14.26mm_W8.61mm_P2.54mm_LowProfile
TP1, TP2, TP3, TP4, TP5, TP6, TP7, TP8, TP9, TP10, TP11, TP12, TP13, TP14, TP15, TP16: TestPoint; TestPoint_Pad_D2.0mm
U1: AP7381-50Y; SOT-89-3
U2: AP3012; SOT-23-5
U3, U4: 74HC4049; SO-16_3.9x9.9mm_P1.27mm
U5, U7: PCA9555PW; TSSOP-24_4.4x7.8mm_P0.65mm
U6: ATtiny861A-S; SOIC-20W_7.5x12.8mm_P1.27mm

Connections:
+5V: C3.1, C4.1, C7.1, C8.1, C9.1, C10.1, J18.2 (VCC), L2.1, R11.2, R37.2, R39.2, R40.2, SW2.1 (A), SW2.4 (A), U1.1 (VO), U2.4 (~SHDN), U2.5 (IN), U3.1 (VCC), U4.1 (VCC), U5.24 (VDD), U6.5 (VCC), U6.15 (AVCC), U7.21 (A0), U7.24 (VDD)
+12V: C6.1, D9.1 (K), R16.2, R22.1, R23.1, R24.1, R25.1, R26.2, R27.1, SW1.3 (C), SW1.6 (C), TP15.1
/A_ADJACENT: D10.1 (A1), D12.2 (A), J8.6, J13.4, J17.3, R22.2, R30.1
/A_ADV_APPROACH: J13.1, R25.2, R34.1
/A_APPROACH: J8.3, J13.2, R26.1, R33.1
/A_DIV_APRCH: J13.8, R28.2, R36.1
/A_L_SIGNAL_G: J18.4 (MOSI), JP12.1 (A), R14.1, U6.1 (PB0)
/A_L_SIGNAL_R: JP8.1 (A), R9.1, U6.14 (PA4)
/A_L_SIGNAL_Y: JP10.1 (A), R12.1, U6.17 (AREF/PA3)
/A_U_SIGNAL_G: JP6.1 (A), R7.1, U6.13 (PA5)
/A_U_SIGNAL_R: JP1.1 (A), R3.1, U6.11 (PA7)
/A_U_SIGNAL_Y: JP3.1 (A), R5.1, U6.12 (PA6)
/B_ADJACENT: D7.1 (A1), D11.2 (A), J8.4, J13.6, J16.3, R23.2, R31.1
/B_ADV_APPROACH: J8.1, R27.2, R35.1
/B_APPROACH: J8.2, J13.3, R24.2, R32.1
/B_DIV_APRCH: J8.8, R29.2, R38.1
/B_L_SIGNAL_G: J18.1 (MISO), JP13.1 (A), R15.1, U6.2 (PB1)
/B_L_SIGNAL_R: JP9.1 (A), R10.1, U6.4 (PB3)
/B_L_SIGNAL_Y: J18.3 (SCK), JP11.1 (A), R13.1, U6.3 (PB2)
/B_U_SIGNAL_G: JP7.1 (A), R8.1, U6.7 (XTAL1/PB4)
/B_U_SIGNAL_R: JP2.1 (A), R4.1, U6.9 (PB6)
/B_U_SIGNAL_Y: JP4.1 (A), R6.1, U6.8 (XTAL2/PB5)
/COM_SENSE: R21.1, U6.19 (PA1)
/MSS_V2: U3.4, U5.4 (IO0_0)
/OPTION_A: SW7.10, U5.7 (IO0_3)
/OPTION_B: SW7.9, U5.8 (IO0_4)
/OPTION_C: SW7.8, U5.9 (IO0_5)
/OPTION_D: SW7.7, U5.10 (IO0_6)
/OPTION_E: SW7.6, U5.11 (IO0_7)
/SCL: R39.1, U5.22 (SCL), U6.18 (PA2), U7.22 (SCL)
/SDA: R40.1, U5.23 (SDA), U6.20 (PA0), U7.23 (SDA)
/SW_A: C2.1, SW3.1, SW3.2, U5.5 (IO0_1)
/SW_B: C5.1, SW4.1, SW4.2, U5.6 (IO0_2)
/VPWR: C1.1, D1.1 (K), D2.1 (K), J15.2, J16.2, J17.2, U1.3 (VI)
GND: C1.2, C2.2, C3.2, C4.2, C5.2, C6.2, C7.2, C8.2, C9.2, C10.2, C11.2, C12.2, C13.2, C14.2, C15.2, C16.2, C17.2, C18.2, C19.2, C20.2, C21.2, D4.2 (A), D5.2 (A), D7.2 (A2), D8.1 (K), D10.2 (A2), D19.1 (K), D20.1 (K), D21.1 (K), D22.1 (K), D23.1 (K), D24.1 (K), J8.5, J13.5, J15.1, J15.MP (MountPin), J16.1, J16.MP (MountPin), J17.1, J17.MP (MountPin), J18.6 (GND), R2.2, R20.1, R41.2, SW1.1 (A), SW1.4 (A), SW2.3 (C), SW2.6 (C), SW3.3, SW3.4, SW4.3, SW4.4, SW5.3, SW5.4, SW6.3, SW6.4, SW7.1, SW7.2, SW7.3, SW7.4, SW7.5, U1.2 (GND), U2.2 (GND), U3.7, U3.8 (VSS), U4.3, U4.8 (VSS), U5.2 (A1), U5.3 (A2), U5.12 (VSS), U5.21 (A0), U6.6 (GND), U6.16 (AGND), U7.2 (A1), U7.3 (A2), U7.12 (VSS)
unnamed: C11.1, J18.5 (~RESET), R37.1, U6.10 (~RESET/PB7)
unnamed: C12.1, R31.2, U3.11
unnamed: C13.1, R33.2, U3.9
unnamed: C14.1, R35.2, U4.7
unnamed: C15.1, R38.2, U3.3
unnamed: C16.1, R30.2, U3.14
unnamed: C17.1, R32.2, U4.11
unnamed: C18.1, R34.2, U4.14
unnamed: C19.1, R36.2, U4.9
unnamed: C20.1, SW5.1, SW5.2, U7.19 (IO1_6)
unnamed: C21.1, SW6.1, SW6.2, U7.20 (IO1_7)
unnamed: D1.2 (A), D5.1 (K), J3.1, TP1.1
unnamed: D2.2 (A), D4.1 (K), J3.2, TP2.1
unnamed: D3.1 (K), D6.1 (K), R2.1
unnamed: D3.2 (A), U7.4 (IO0_0)
unnamed: D6.2 (A), U7.5 (IO0_1)
unnamed: D8.2 (A), R11.1
unnamed: D9.2 (A), L2.2, U2.1 (SW)
unnamed: D11.1 (K), D12.1 (K), J15.3
unnamed: D13.1 (K), D14.1 (K), D15.1 (K), D16.1 (K), D17.1 (K), D18.1 (K), R41.1
unnamed: D13.2 (A), U7.6 (IO0_2)
unnamed: D14.2 (A), U7.7 (IO0_3)
unnamed: D15.2 (A), U7.8 (IO0_4)
unnamed: D16.2 (A), U7.9 (IO0_5)
unnamed: D17.2 (A), U7.10 (IO0_6)
unnamed: D18.2 (A), U7.11 (IO0_7)
unnamed: D19.2 (A), R42.2
unnamed: D20.2 (A), R43.2
unnamed: D21.2 (A), R44.2
unnamed: D22.2 (A), R45.2
unnamed: D23.2 (A), R46.2
unnamed: D24.2 (A), R47.2
unnamed: J1.1, J5.2, JP3.2 (B), R5.2, TP5.1
unnamed: J1.2, J5.3, JP6.2 (B), R7.2, TP7.1
unnamed: J1.3, J5.1, JP1.2 (B), R3.2, TP3.1
unnamed: J1.4, J1.MP (MountPin), J2.4, J2.MP (MountPin), J7.1, J7.2, J7.3, J11.4, J11.MP (MountPin), J12.4, J12.MP (MountPin), R21.2, SW2.2 (B), SW2.5 (B), TP16.1
unnamed: J2.1, J6.2, JP4.2 (B), R6.2, TP6.1
unnamed: J2.2, J6.3, JP7.2 (B), R8.2, TP8.1
unnamed: J2.3, J6.1, JP2.2 (B), R4.2, TP4.1
unnamed: J10.1, J12.3, JP9.2 (B), R10.2, TP10.1
unnamed: J10.2, J12.1, JP11.2 (B), R13.2, TP12.1
unnamed: J10.3, J12.2, JP13.2 (B), R15.2, TP14.1
unnamed: J9.2, J11.1, JP10.2 (B), R12.2, TP11.1
unnamed: J9.3, J11.2, JP12.2 (B), R14.2, TP13.1
unnamed: J9.1, J11.3, JP8.2 (B), R9.2, TP9.1
unnamed: J8.7, J13.7
unnamed: R1.1, U3.5
unnamed: R1.2, R28.1, R29.1, SW1.2 (B), SW1.5 (B)
unnamed: R16.1, R17.2
unnamed: R17.1, R18.2, U2.3 (FB)
unnamed: R18.1, R19.2
unnamed: R19.1, R20.2
unnamed: R42.1, U7.13 (IO1_0)
unnamed: R43.1, U7.14 (IO1_1)
unnamed: R44.1, U7.15 (IO1_2)
unnamed: R45.1, U7.16 (IO1_3)
unnamed: R46.1, U7.17 (IO1_4)
unnamed: R47.1, U7.18 (IO1_5)
unnamed: U3.2, U5.19 (IO1_6)
unnamed: U3.10, U5.16 (IO1_3)
unnamed: U3.12, U5.17 (IO1_4)
unnamed: U3.15, U5.18 (IO1_5)
unnamed: U4.6, U5.20 (IO1_7)
unnamed: U4.10, U5.13 (IO1_0)
unnamed: U4.12, U5.14 (IO1_1)
unnamed: U4.15, U5.15 (IO1_2)

Notes on the sheet:
UPPER HEAD
Signal A-Upper - Yellow LED
APPROACH
Common Anode / Common Cathode Selector Switch
Atlas Signal Connector for Signal A Upper Molex Picoblade 1 - Yellow 2 - Green 3 - Red 4 - Common
LOWER HEAD
Signal A-Lower - Green LED
MSS 2v3 (up is v2)
MSS Port A
IRSense
Signal B-Lower - Red LED
Signal A-Lower - Yellow LED
CLEAR
BD1 Port B
MSS Port B
APPROACH DIV
SIG A CONF
Atlas Signal Connector for Signal B-Upper Molex Picoblade 1 - Yellow 2 - Green 3 - Red 4 - Common
STOP
BD1 Port A
Signals Common Terminal
ADV APPROACH
SIG B CONF
Signal B-Upper - Red LED
APPROACH DIV + AA
Signal A-Lower - Red LED
Signal B-Lower - Green LED
Atlas Signal Connector for Signal B-Lower Molex Picoblade 1 - Yellow 2 - Green 3 - Red 4 - Common
Atlas Signal Connector for Signal A-Lower Molex Picoblade 1 - Yellow 2 - Green 3 - Red 4 - Common
Signal A-Upper - Green LED
Signal B-Upper - Green LED
Signal B-Lower - Yellow LED
Signal B-Upper - Yellow LED
Signal A-Upper - Red LED
MSS Pinout --------------------------- 1 - Adv Aprch In 2 - Approach In 3 - Adv Aprch Out 4 - Current Block In/Out 5 - Ground 6 - Approach Out 7 - Reserved 8 - Approach Diverging (In or Out)

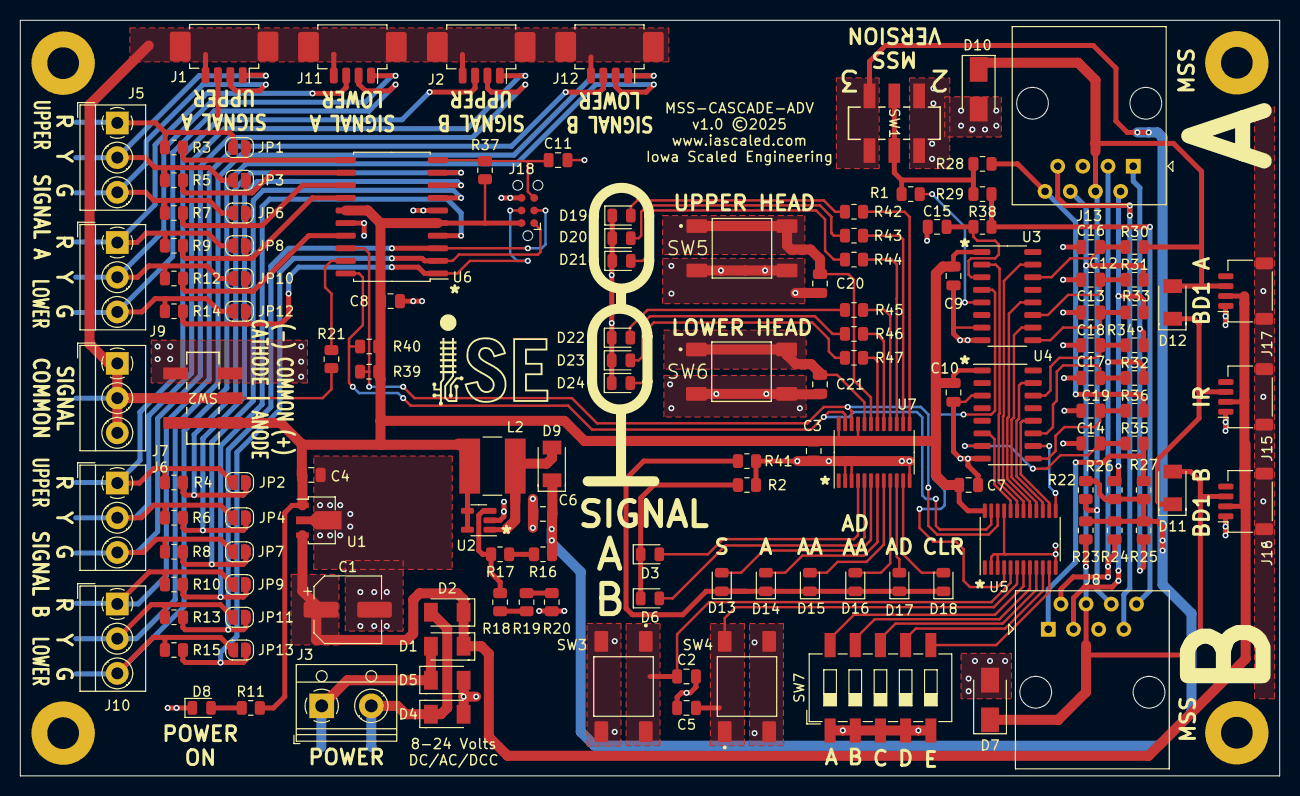
[picture p32: board mss-cascade-adv.kicad_pcb from above]

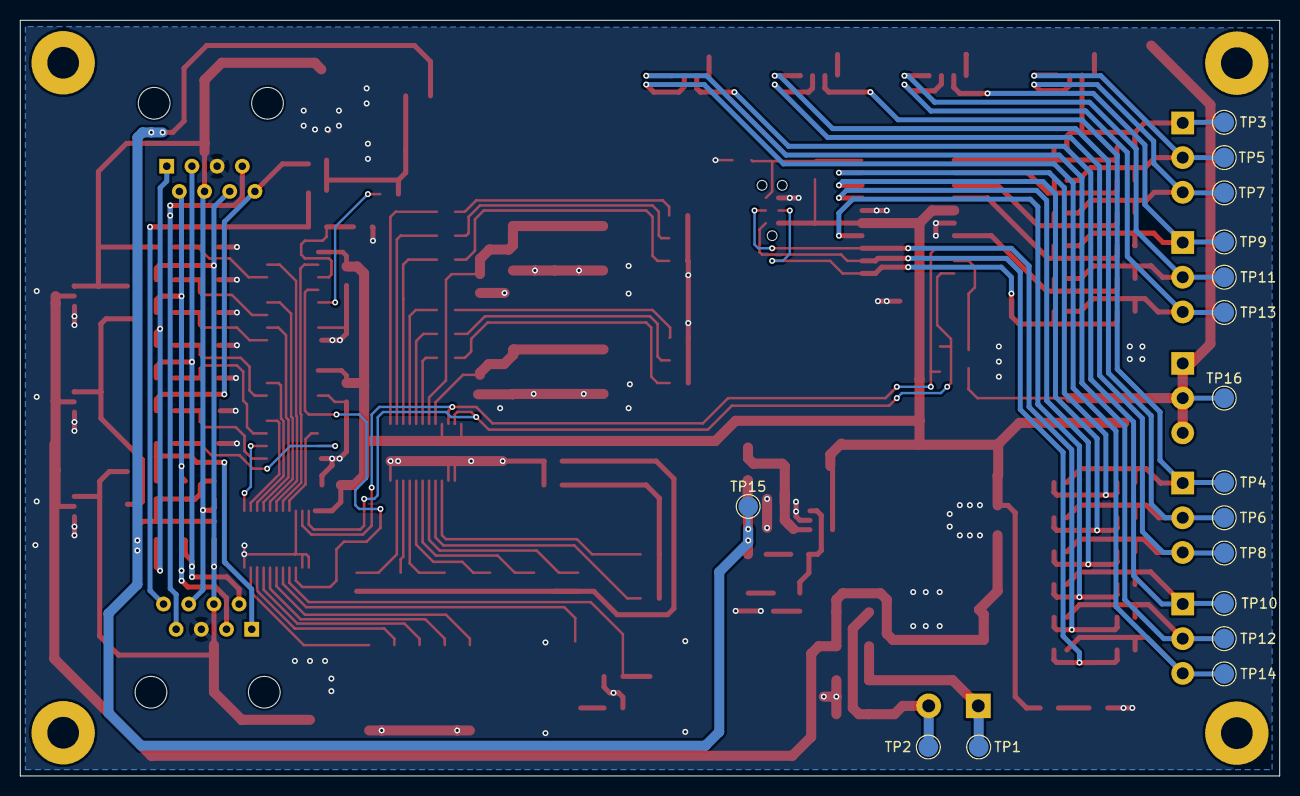
[picture p33: board mss-cascade-adv.kicad_pcb from below]

Board: 2 copper layers, 127.0 x 76.2 mm, 155 parts (16 on the bottom side), 101 nets.
