IowaScaledEngineering/mss-cascade/kicad/mss-cascade-basic/mss-cascade-basic.kicad_pcb

## KiCad design kicad/mss-cascade-basic/mss-cascade-basic.kicad_pcb (2024-08-26)

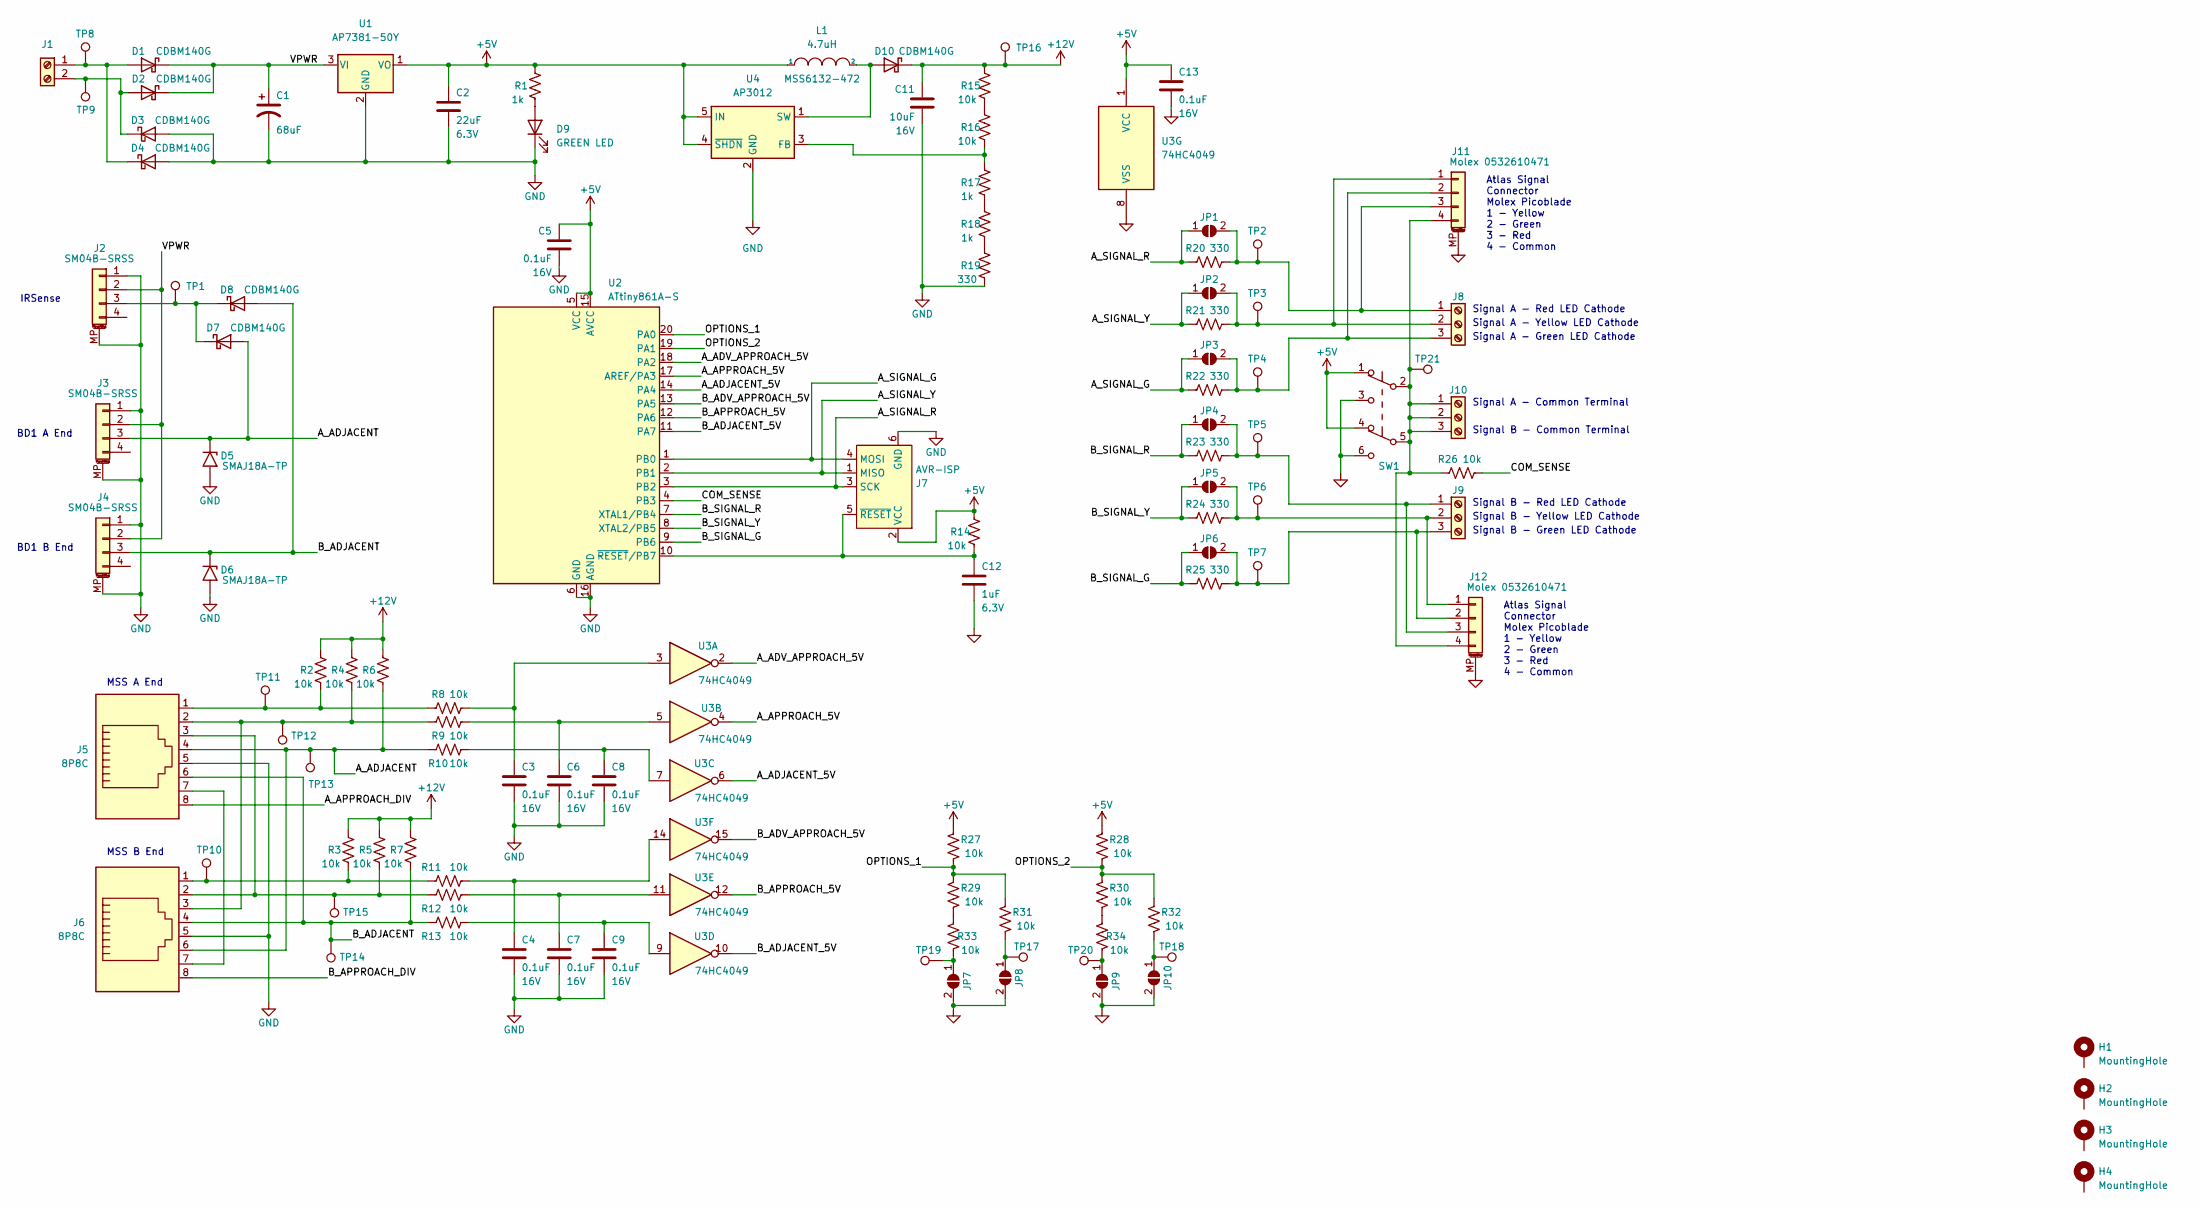
[picture p34: schematic mss-cascade-basic.kicad_sch, MSS Cascade Basic v1.0]

Parts:
C1: 68uF; CP_Elec_6.3x5.8
C2: 22uF; C_0805_2012Metric; Voltage 6.3V
C3, C4, C5, C6, C7, C8, C9, C13: 0.1uF; C_0805_2012Metric; Voltage 16V
C11: 10uF; C_0805_2012Metric; Voltage 16V
C12: 1uF; C_0805_2012Metric; Voltage 6.3V
D1, D2, D3, D4, D7, D8, D10: CDBM140G; SOD-123T
D5, D6: SMAJ18A-TP; D_SMA
D9: GREEN LED; LED_0805_2012Metric
H1, H2, H3, H4: MountingHole; MountingHole_3.2mm_M3_Pad
J1: Screw_Terminal_01x02; TerminalBlock_RND_205-00012_1x02_P5.00mm_Horizontal
J2, J3, J4: SM04B-SRSS; JST_SH_SM04B-SRSS-TB_1x04-1MP_P1.00mm_Horizontal
J5, J6: 8P8C; RJ45_Amphenol_54602-x08_Horizontal
J7: AVR-ISP; Tag-Connect_TC2030-IDC-NL_2x03_P1.27mm_Vertical
J8, J9, J10: Screw_Terminal_01x02; TerminalBlock_MetzConnect_Type059_RT06303HBWC_1x03_P3.50mm_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
J11, J12: Molex 0532610471; Molex_PicoBlade_53261-0471_1x04-1MP_P1.25mm_Horizontal
JP1, JP2, JP3, JP4, JP5, JP6, JP7, JP8, JP9, JP10: SolderJumper_2_Open; SolderJumper-2_P1.3mm_Open_RoundedPad1.0x1.5mm
L1: 4.7uH; MSS6132-xxxMLC
R1, R17, R18: 1k; R_0805_2012Metric
R2, R3, R4, R5, R6, R7, R8, R9, R10, R11, R12, R13, R14, R15, R16, R26, R27, R28, R29, R30, R31, R32, R33, R34: 10k; R_0805_2012Metric
R19, R20, R21, R22, R23, R24, R25: 330; R_0805_2012Metric
SW1: JS202011SCQN; SW_JS202011SCQN
TP1, TP2, TP3, TP4, TP5, TP6, TP7, TP8, TP9, TP10, TP11, TP12, TP13, TP14, TP15, TP16, TP17, TP18, TP19, TP20, TP21: TestPoint; TestPoint_Pad_D2.0mm
U1: AP7381-50Y; SOT-89-3
U2: ATtiny861A-S; SOIC-20W_7.5x12.8mm_P1.27mm
U3: 74HC4049; SO-16_3.9x9.9mm_P1.27mm
U4: AP3012; SOT-23-5

Connections:
+5V: C2.1, C5.1, C13.1, J7.2 (VCC), L1.1, R1.2, R14.2, R27.2, R28.2, SW1.1 (A), SW1.4 (A), U1.1 (VO), U2.5 (VCC), U2.15 (AVCC), U3.1 (VCC), U4.4 (~SHDN), U4.5 (IN)
+12V: C11.1, D10.1 (K), R2.2, R3.2, R4.2, R5.2, R6.2, R7.2, R15.2, TP16.1
/A_ADJACENT: D5.1 (A1), D7.2 (A), J3.3, J5.4, J6.6, R6.1, R10.2, TP13.1
/A_ADJACENT_5V: U2.14 (PA4), U3.6
/A_ADV_APPROACH_5V: U2.18 (PA2), U3.2
/A_APPROACH_5V: U2.17 (AREF/PA3), U3.4
/A_APPROACH_DIV: J5.8
/A_SIGNAL_G: J7.4 (MOSI), JP3.1 (A), R22.1, U2.1 (PB0)
/A_SIGNAL_R: J7.3 (SCK), JP1.1 (A), R20.1, U2.3 (PB2)
/A_SIGNAL_Y: J7.1 (MISO), JP2.1 (A), R21.1, U2.2 (PB1)
/B_ADJACENT: D6.1 (A1), D8.2 (A), J4.3, J5.6, J6.4, R7.1, R13.2, TP14.1
/B_ADJACENT_5V: U2.11 (PA7), U3.10
/B_ADV_APPROACH_5V: U2.13 (PA5), U3.15
/B_APPROACH_5V: U2.12 (PA6), U3.12
/B_APPROACH_DIV: J6.8
/B_SIGNAL_G: JP6.1 (A), R25.1, U2.9 (PB6)
/B_SIGNAL_R: JP4.1 (A), R23.1, U2.7 (XTAL1/PB4)
/B_SIGNAL_Y: JP5.1 (A), R24.1, U2.8 (XTAL2/PB5)
/COM_SENSE: R26.2, U2.4 (PB3)
/OPTIONS_1: R27.1, R29.2, R31.2, U2.20 (PA0)
/OPTIONS_2: R28.1, R30.2, R32.2, U2.19 (PA1)
/VPWR: C1.1, D1.1 (K), D2.1 (K), J2.2, J3.2, J4.2, U1.3 (VI)
GND: C1.2, C2.2, C3.2, C4.2, C5.2, C6.2, C7.2, C8.2, C9.2, C11.2, C12.2, C13.2, D3.2 (A), D4.2 (A), D5.2 (A2), D6.2 (A2), D9.1 (K), J2.1, J2.MP (MountPin), J3.1, J3.MP (MountPin), J4.1, J4.MP (MountPin), J5.5, J6.5, J7.6 (GND), J11.MP (MountPin), J12.MP (MountPin), JP7.2 (B), JP8.2 (B), JP9.2 (B), JP10.2 (B), R19.1, SW1.3 (C), SW1.6 (C), U1.2 (GND), U2.6 (GND), U2.16 (AGND), U3.8 (VSS), U4.2 (GND)
unnamed: C3.1, R8.1, U3.3
unnamed: C4.1, R11.1, U3.14
unnamed: C6.1, R9.1, U3.5
unnamed: C7.1, R12.1, U3.11
unnamed: C8.1, R10.1, U3.7
unnamed: C9.1, R13.1, U3.9
unnamed: C12.1, J7.5 (~RESET), R14.1, U2.10 (~RESET/PB7)
unnamed: D1.2 (A), D4.1 (K), J1.1, TP8.1
unnamed: D2.2 (A), D3.1 (K), J1.2, TP9.1
unnamed: D7.1 (K), D8.1 (K), J2.3, TP1.1
unnamed: D9.2 (A), R1.1
unnamed: D10.2 (A), L1.2, U4.1 (SW)
unnamed: J5.1, R2.1, R8.2, TP11.1
unnamed: J5.2, J6.3, R4.1, R9.2, TP12.1
unnamed: J5.3, J6.2, R5.1, R12.2, TP15.1
unnamed: J5.7, J6.7
unnamed: J6.1, R3.1, R11.2, TP10.1
unnamed: J10.1, J10.2, J10.3, J11.4, J12.4, R26.1, SW1.2 (B), SW1.5 (B), TP21.1
unnamed: J8.2, J11.1, JP2.2 (B), R21.2, TP3.1
unnamed: J8.3, J11.2, JP3.2 (B), R22.2, TP4.1
unnamed: J8.1, J11.3, JP1.2 (B), R20.2, TP2.1
unnamed: J9.2, J12.1, JP5.2 (B), R24.2, TP6.1
unnamed: J9.3, J12.2, JP6.2 (B), R25.2, TP7.1
unnamed: J9.1, J12.3, JP4.2 (B), R23.2, TP5.1
unnamed: JP7.1 (A), R33.1, TP19.1
unnamed: JP8.1 (A), R31.1, TP17.1
unnamed: JP9.1 (A), R34.1, TP20.1
unnamed: JP10.1 (A), R32.1, TP18.1
unnamed: R15.1, R16.2
unnamed: R16.1, R17.2, U4.3 (FB)
unnamed: R17.1, R18.2
unnamed: R18.1, R19.2
unnamed: R29.1, R33.2
unnamed: R30.1, R34.2

Notes on the sheet:
IRSense
Signal A - Yellow LED Cathode
Signal A - Red LED Cathode
Signal A - Common Terminal
Atlas Signal Connector Molex Picoblade 1 - Yellow 2 - Green 3 - Red 4 - Common
Signal B - Red LED Cathode
Signal B - Green LED Cathode
MSS B End
Signal B - Common Terminal
Signal B - Yellow LED Cathode
BD1 A End
BD1 B End
Signal A - Green LED Cathode
MSS A End
