IowaScaledEngineering/mss-cascade/kicad/mss-cascade-basic/mss-cascade-basic.kicad_pcb

## KiCad design kicad/mss-cascade-basic/mss-cascade-basic.kicad_pcb (continued)

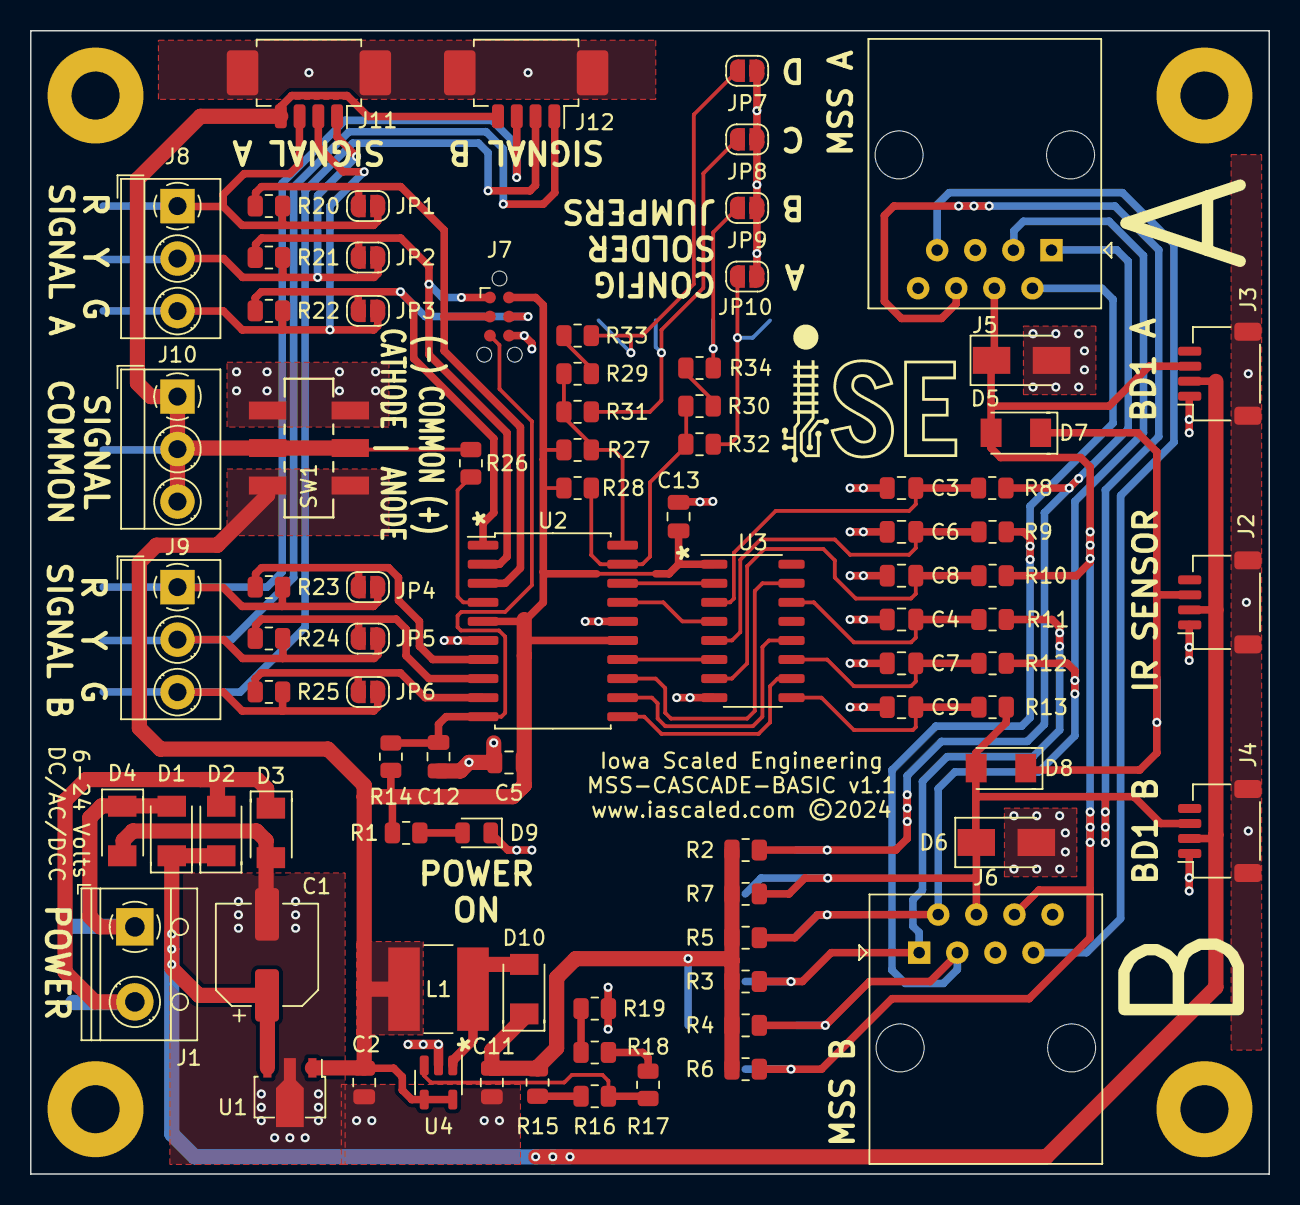
[picture p35: board mss-cascade-basic.kicad_pcb from above]

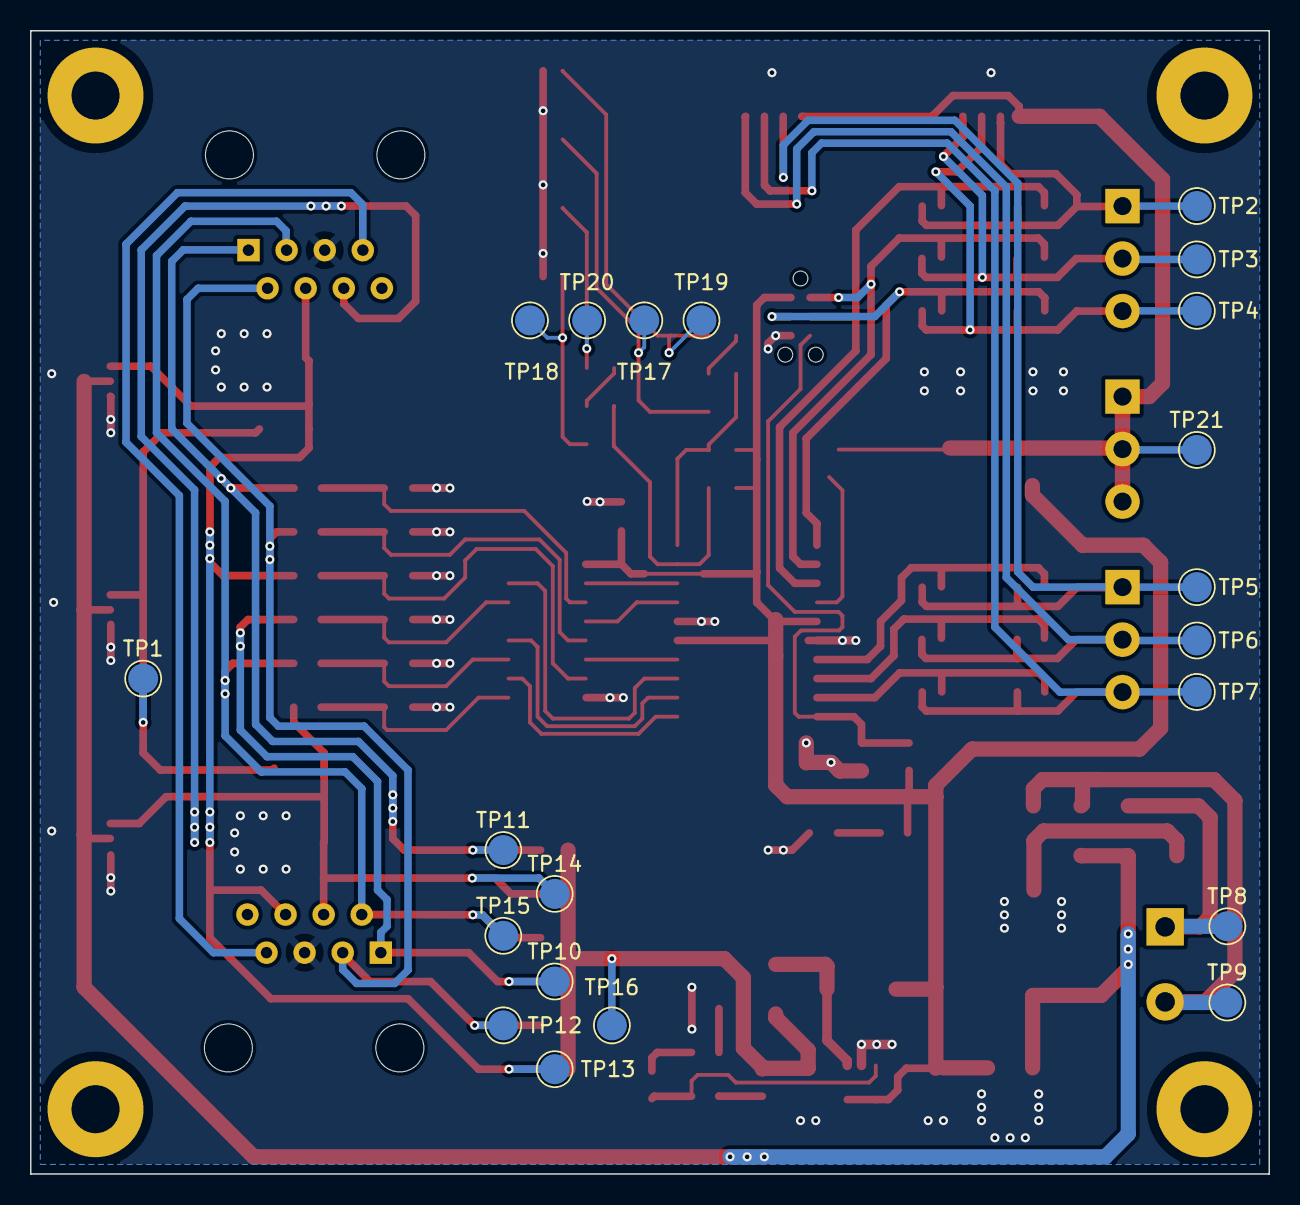
[picture p36: board mss-cascade-basic.kicad_pcb from below]

Board: 2 copper layers, 82.6 x 76.2 mm, 109 parts (21 on the bottom side), 55 nets.
