IowaScaledEngineering/mss-cascade/(commit log)

2015-10-14 Initial work on Free-mo Modular Signal System integrated cascade board
    [mss-cascade.sch]
2015-10-14 Update description text on schematic
    [mss-cascade.sch]
2015-11-09 Upgrade to atmega165a and put in new bus sensing section with 74hc4049
    [mss-cascade.sch]
2015-11-24 Cascade, simplified. Removed giant AVR, replaced with attiny48 and some i2c I/O
    [mss-cascade.sch]
2015-11-24 Putting it back to the mega165a and fixing all the refdes
    [mss-cascade.sch]
2015-11-25 Change refdes on optical occupancy indicator led
    [mss-cascade.sch]
2015-11-29 Now goes through gsch2pcb relatively cleanly
    [mss-cascade.sch]
2015-11-29 Forgot to add the header symbol for the pin 5-7 jumper
2015-11-29 Minor pinout and footprint adjustments
    [mss-cascade.sch]
2015-11-30 Changes needed to make the PCB work - mostly pin changes
    [mss-cascade.pcb, mss-cascade.sch]
2015-11-30 Add more plane
    [mss-cascade.pcb]
2015-12-01 Misc changes, add LEDs to 3.3 and 12V rails, etc.
    [mss-cascade.pcb, mss-cascade.sch]
2015-12-03 Move U9 further from the switches and add pin 1 markers to the SOs
    [mss-cascade.pcb]
2015-12-03 Add 1.0 pg
    [mss-cascade.bottom.gbr, mss-cascade.bottommask.gbr, mss-cascade.bottompaste.gbr, mss-cascade.bottomsilk.gbr, mss-cascade.fab.gbr, mss-cascade.outline.gbr, mss-cascade.top.gbr, mss-cascade.topmask.gbr]
2015-12-31 Add initial framework for development
2016-01-01 Incremental work towards bringing up the MSS board
2016-01-02 More changes. initial support for 3-wire R/G LEDs.
2016-01-02 Add 2 wire RG LED support Implement suppression of blinkies
2016-06-07 Change 12V rail to a boost converter
    [mss-cascade.sch]
2016-06-24 Fix various logic issues
    [mss-cascade.c]
2016-06-24 Fix 2-lead R/G LED drives on A1, A2, and B2 channels
    [mss-cascade.c]
2016-06-24 Fix up refdes issues with new regulator
    [mss-cascade.sch]
2016-06-24 Changes to add a switching regulator to provide +12V for the MSS bus
    [mss-cascade.pcb, mss-cascade.sch]
2016-09-06 Changes to add wiring diagrams to manual and correct typos
2016-09-06 Update wiring image
2016-09-14 Add provision for MSS standard possibly reversing the logic on the diverging approach line
    [mss-cascade.pcb, mss-cascade.sch]
2016-09-14 Just additional cleanup of the pcb
    [mss-cascade.pcb]
2016-09-14 Change out input protection circuit for a new one
    [mss-cascade.pcb, mss-cascade.sch]
2016-09-14 Fix copyright date
    [mss-cascade.pcb]
2016-09-17 Add cascade v1.1
    [mss-cascade.bottom.gbr, mss-cascade.bottommask.gbr, mss-cascade.bottompaste.gbr, mss-cascade.bottomsilk.gbr, mss-cascade.fab.gbr, mss-cascade.outline.gbr, mss-cascade.top.gbr, mss-cascade.topmask.gbr]
2024-05-14 Draft version of an mss-cascade-basic
    [mss-cascade-basic.kicad_pcb, mss-cascade-basic.kicad_sch]
2024-05-23 Schematic updates and moving things around on the basic
    [mss-cascade-basic.kicad_pcb, mss-cascade-basic.kicad_sch]
2024-06-03 Initial PCB layout for basic cascade
    [mss-cascade-basic.kicad_pcb, mss-cascade-basic.kicad_sch]
2024-06-03 Add 3d models to footprints
    [mss-cascade-basic.kicad_pcb]
2024-06-09 Add test point for 12V, move connectors to align
    [mss-cascade-basic.kicad_pcb, mss-cascade-basic.kicad_sch]
2024-07-09 Sent to fab July 2024
    [mss-cascade-basic-NPTH.drl, mss-cascade-basic.drl, mss-cascade-basic.gbl, mss-cascade-basic.gbo, mss-cascade-basic.gbp, mss-cascade-basic.gbr, mss-cascade-basic.gbs, mss-cascade-basic.gm1]
2024-07-24 Update diode footprints on the cascade basic for proper SOD123T on all of the CDBM140Gs Update version to 1.1
    [mss-cascade-basic.kicad_pcb, mss-cascade-basic.kicad_sch]
2024-07-25 Factor out the searchlight PWM values and make them defined with macros rather than magic values from my spreadsheet
2024-08-19 Preliminary addition of Atlas signal connectors and the ability to set common anode or cathode
    [mss-cascade-basic.kicad_pcb, mss-cascade-basic.kicad_sch]
2024-08-19 A few cleanup things
    [mss-cascade-basic.kicad_pcb]
2024-08-26 Change text, add test point for common
    [mss-cascade-basic.kicad_pcb, mss-cascade-basic.kicad_sch]
2024-08-26 Add cascade basic pg 1.1
    [mss-cascade-basic-NPTH.drl, mss-cascade-basic.drl, mss-cascade-basic.gbl, mss-cascade-basic.gbo, mss-cascade-basic.gbp, mss-cascade-basic.gbr, mss-cascade-basic.gbs, mss-cascade-basic.gm1]
2024-09-16 Refactor signal and mss logic for modularity and fix a bunch of bugs
    [mss-cascade-basic.c, mss.c, mss.h, optionSwitches.h, signalAspect.h]
2024-09-16 Fix some issues with option switches
    [mss-cascade-basic.c]
2024-11-10 Add start of mss-cascade-pro based off the mss-switch
    [mss-cascade-pro.kicad_pcb, mss-cascade-pro.kicad_sch]
2024-11-26 Continued work on cascade pro
    [mss-cascade-pro.kicad_pcb, mss-cascade-pro.kicad_sch]
2024-12-04 Initial cut of the cascade pro idea
    [mss-cascade-pro.kicad_pcb, mss-cascade-pro.kicad_sch]
2024-12-06 PCB Cleanup
    [mss-cascade-pro.kicad_pcb]
2024-12-06 Rename cascade pro to cascade advanced
    [mss-cascade-adv.kicad_pcb, mss-cascade-adv.kicad_sch]
2024-12-23 Initial cut with basic functionality
2024-12-24 Initial working version. Code itself is still a mess, but it works correctly now
    [hardware.h, mss-cascade-adv.c, mss.h, signalAspect.h]
2025-01-05 Add 3d models for RJ45s
    [mss-cascade-adv.kicad_pcb]
2025-02-18 First whack at a cascade basic test jig
    [mss-cascade-basic-testjig.kicad_pcb, mss-cascade-basic-testjig.kicad_sch]
2025-02-23 Fix issues with wire naming
    [mss-cascade-basic-testjig.kicad_pcb, mss-cascade-basic-testjig.kicad_sch]
2025-08-12 PG for the advanced
    [mss-cascade-adv-NPTH.drl, mss-cascade-adv.drl, mss-cascade-adv.gbl, mss-cascade-adv.gbo, mss-cascade-adv.gbp, mss-cascade-adv.gbr, mss-cascade-adv.gbs, mss-cascade-adv.gm1]
