IowaScaledEngineering/mss-cascade/(notices)

Notices in the files:
kicad/mss-cascade-basic/mss-cascade-basic.kicad_pcb:
www.iascaled.com ©2024
kicad/mss-cascade-adv/mss-cascade-adv.kicad_pcb:
v1.0 ©2025
kicad/mss-cascade-basic-testjig/mss-cascade-basic-testjig.kicad_pcb:
www.iascaled.com ©2025
